tpbw4321/Slugnificant-Seven/Electrical/11.10.18 lab notes.pdf

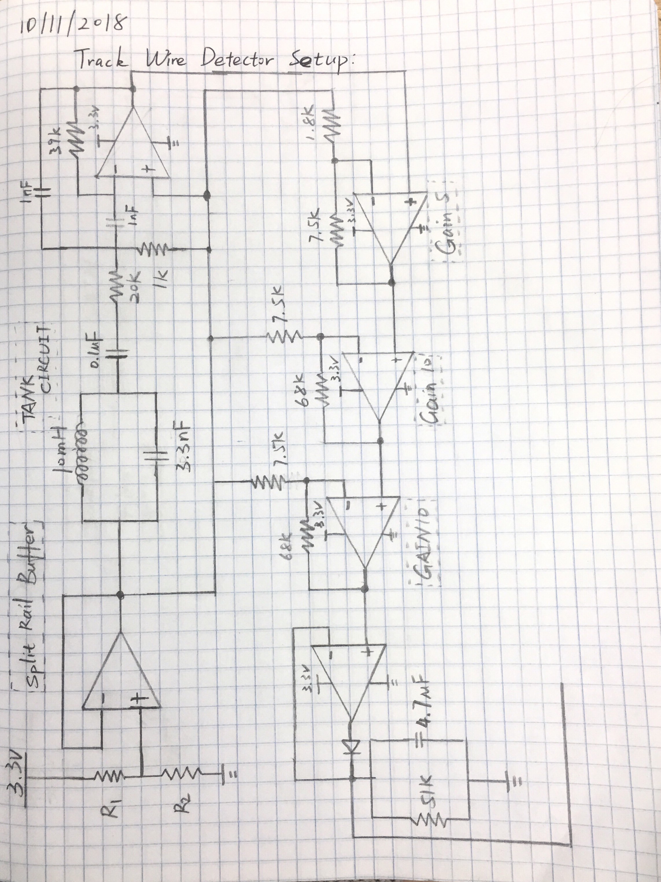
[picture p43: page 1]
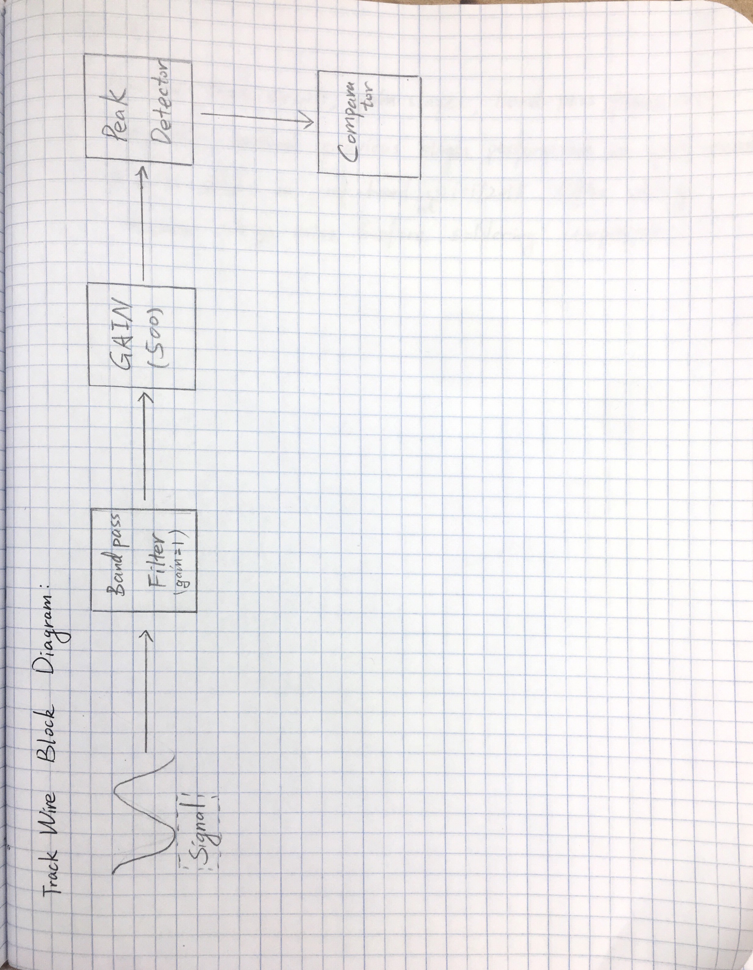
[picture p44: page 2]
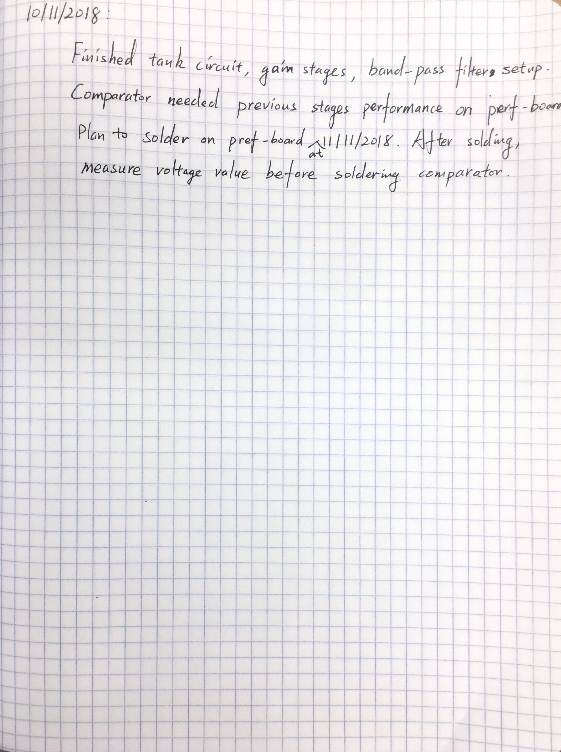
[picture p45: page 3]
