tpbw4321/Slugnificant-Seven/Mechanical/Chassis/MotorizedPlatform.PNG

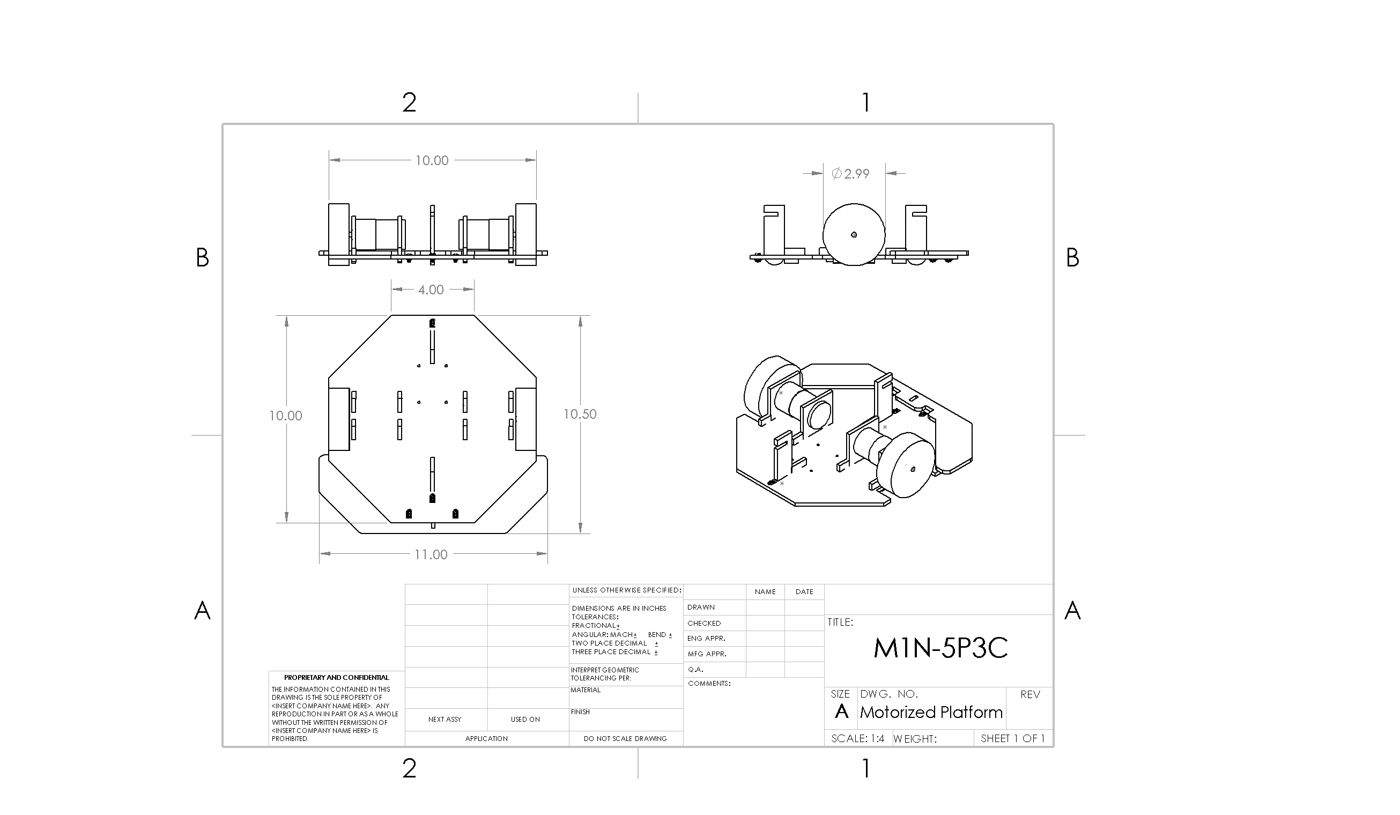
Mechanical/Chassis/MotorizedPlatform.PNG
