tpbw4321/Slugnificant-Seven/Mechanical/Mechanical Report/FiringMechanismProto.jpg

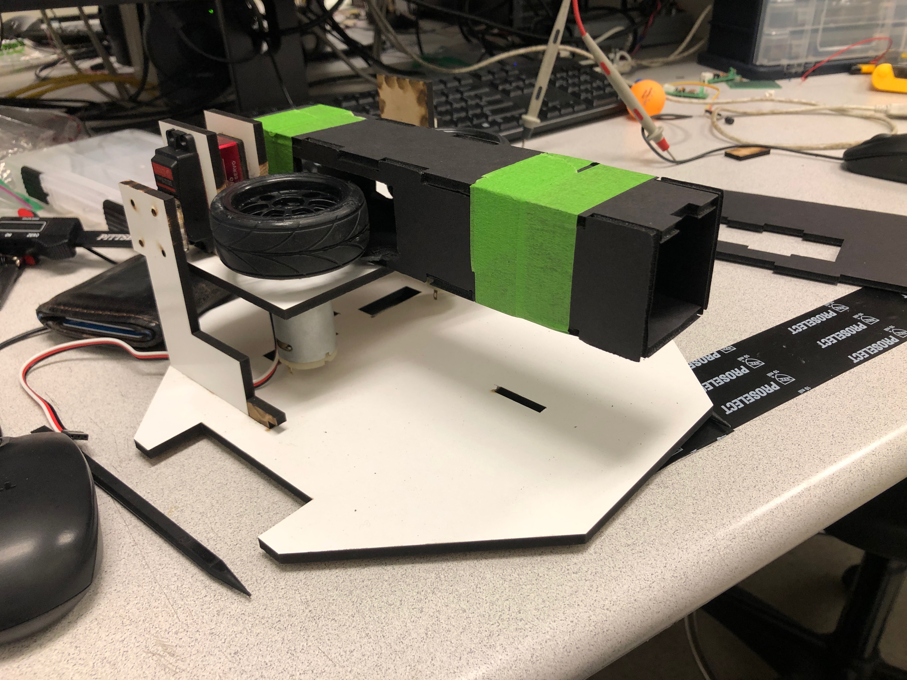
Mechanical/Mechanical Report/FiringMechanismProto.jpg
