tpbw4321/Slugnificant-Seven/Mechanical/Mechanical Report/IMG_2610.jpg

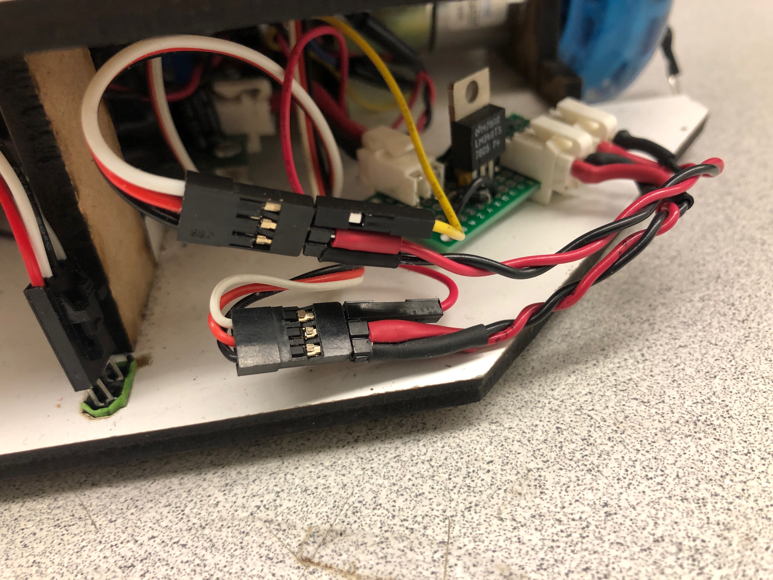
Mechanical/Mechanical Report/IMG_2610.jpg
