tpbw4321/Slugnificant-Seven/Mechanical/Motor/mobile_upload_2017-09-07_154527.jpg

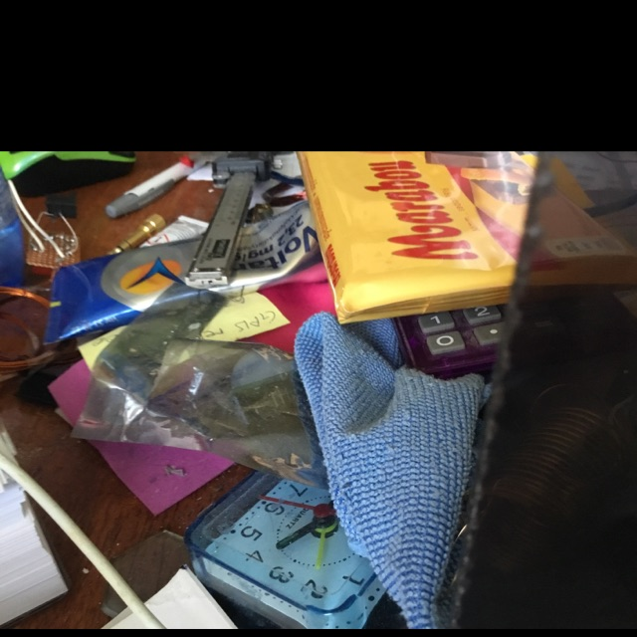
Mechanical/Motor/mobile_upload_2017-09-07_154527.jpg
