tpbw4321/Slugnificant-Seven/Mechanical/Motor/Renderings/DC 12v.296.jpg

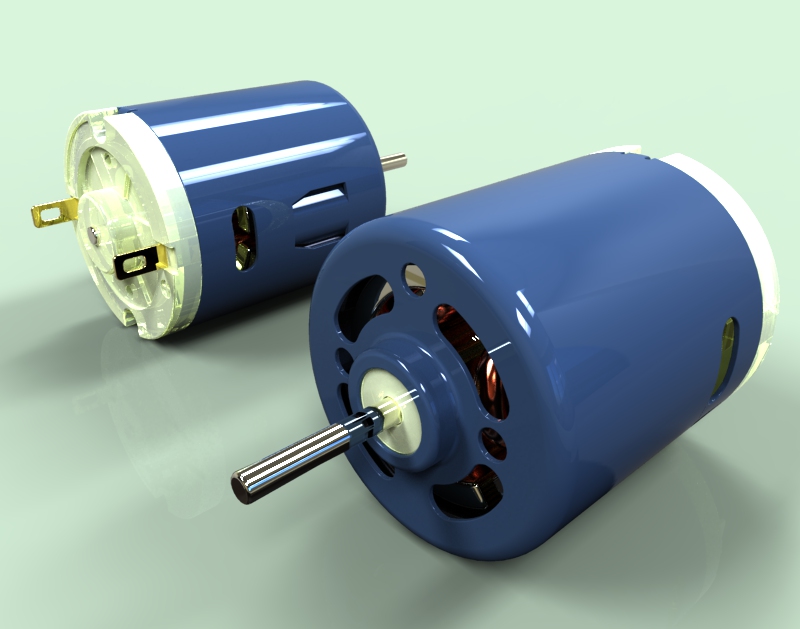
Mechanical/Motor/Renderings/DC 12v.296.jpg
