tpbw4321/Slugnificant-Seven/Mechanical/Motor/Renderings/Motor CC 12V.jpg

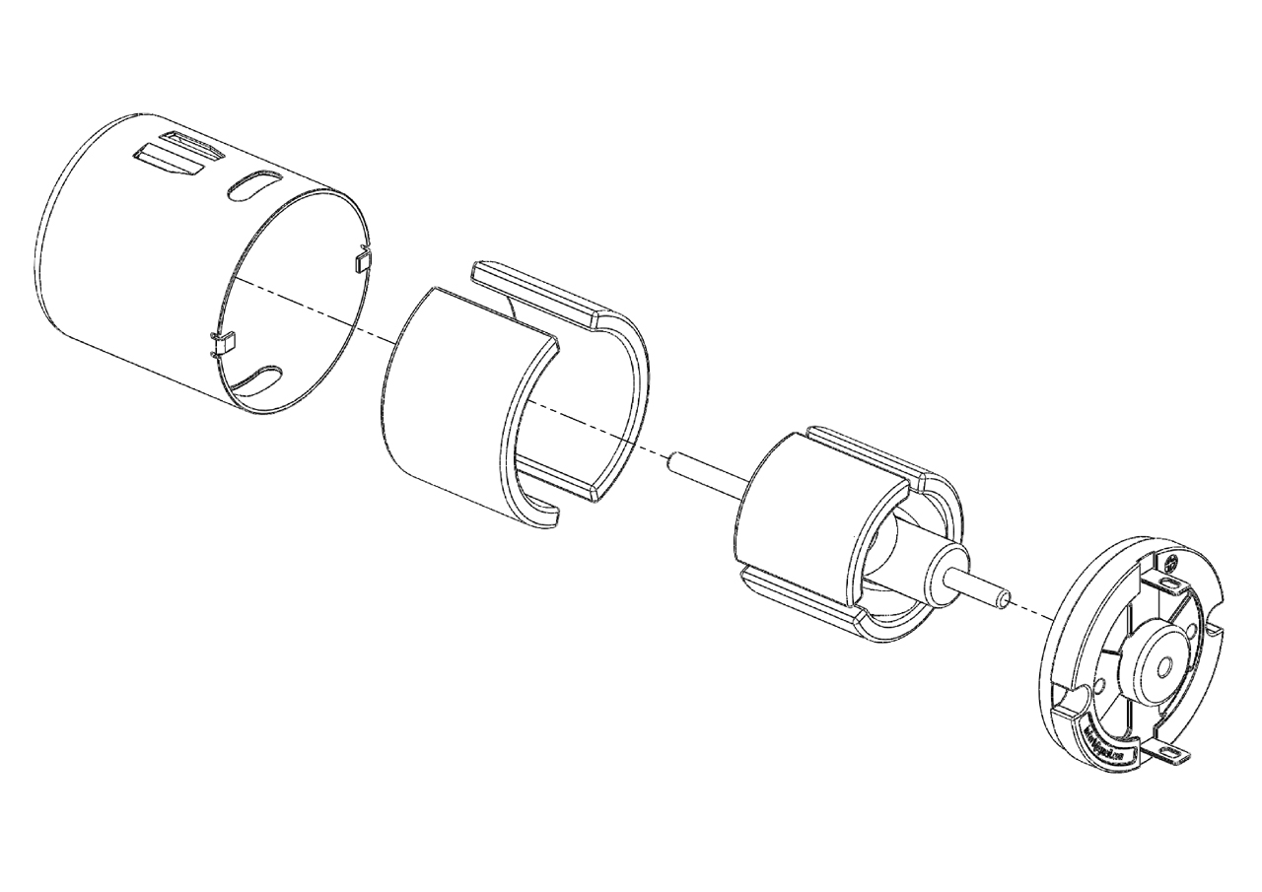
Mechanical/Motor/Renderings/Motor CC 12V.jpg
