tpbw4321/Slugnificant-Seven/Mechanical/Motor/Renderings/Render Motor CC 12V.jpg

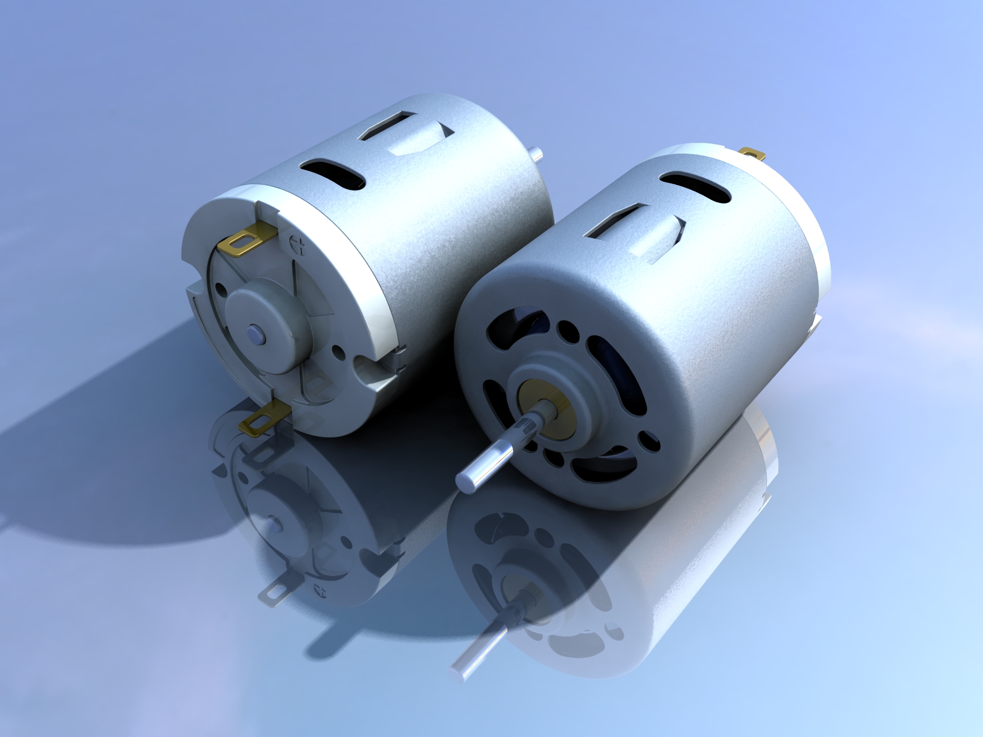
Mechanical/Motor/Renderings/Render Motor CC 12V.jpg
