tpbw4321/Slugnificant-Seven/Mechanical/Chassis/HBridge.SLDASM

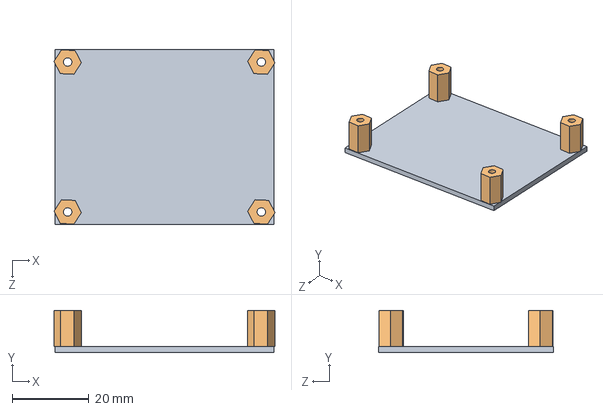
[picture p53: CAD file, 2019-06-20]
Mechanical/Chassis/HBridge.SLDASM
57.7 x 11.0 x 45.7 mm
DRV8814
HexRiser x 4
