tpbw4321/Slugnificant-Seven/Mechanical/LoadingMechanism/S90Servo/SG90 - Micro Servo 9g - Tower Pro.SLDASM

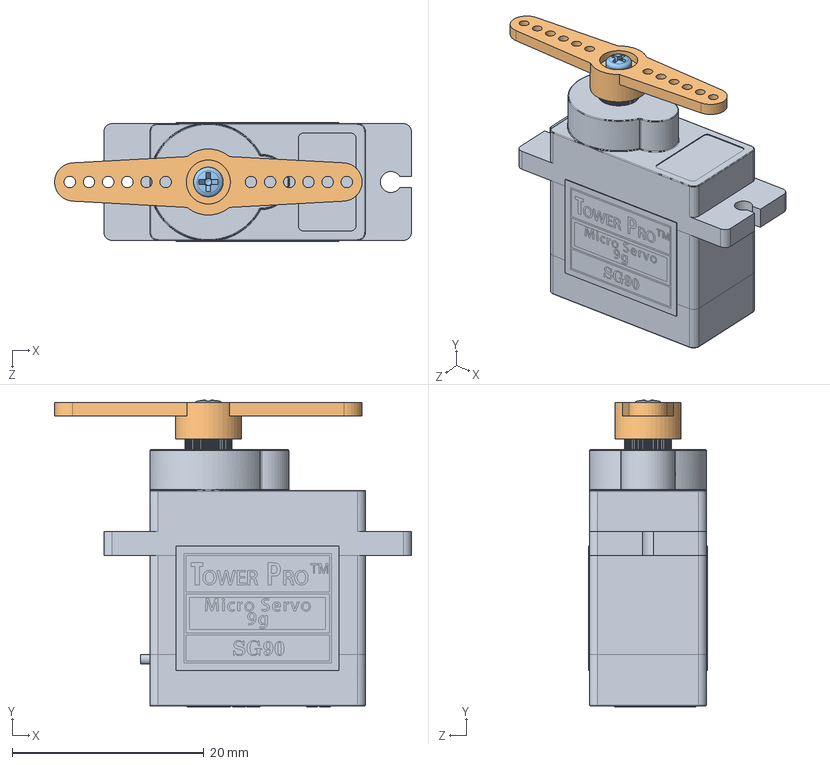
[picture p54: CAD file, 2019-06-20]
Mechanical/LoadingMechanism/S90Servo/SG90 - Micro Servo 9g - Tower Pro.SLDASM
37.2 x 32.0 x 12.4 mm
SG90 - Micro Servo 9g - Tower Pro.1
SG90 - Micro Servo 9g - Tower Pro.3
SG90 - Micro Servo 9g - Tower Pro.6
