tpbw4321/Slugnificant-Seven/Mechanical/FiringMechanism/Lewansoul_LD-27MG.SLDASM

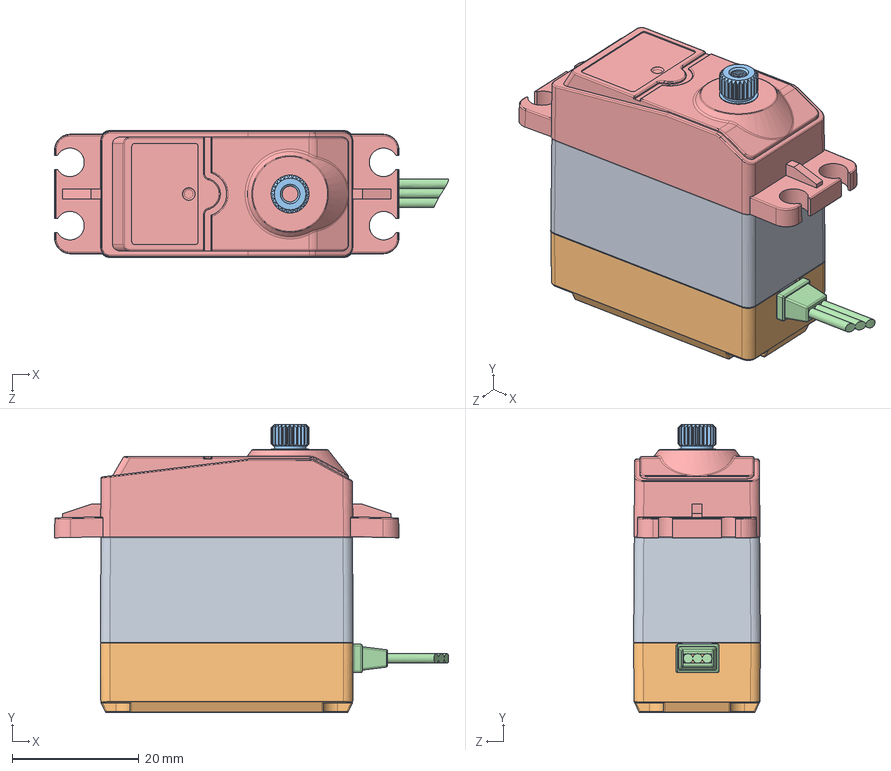
[picture p55: CAD file, 2019-06-20]
Mechanical/FiringMechanism/Lewansoul_LD-27MG.SLDASM
62.2 x 45.5 x 20.0 mm
ZK_1
DG-SZ
GE
XIANTAO
SG-JIANRONG-MG996_1
