tpbw4321/Slugnificant-Seven/Mechanical/LoadingMechanism/LoadingMechanism.SLDASM

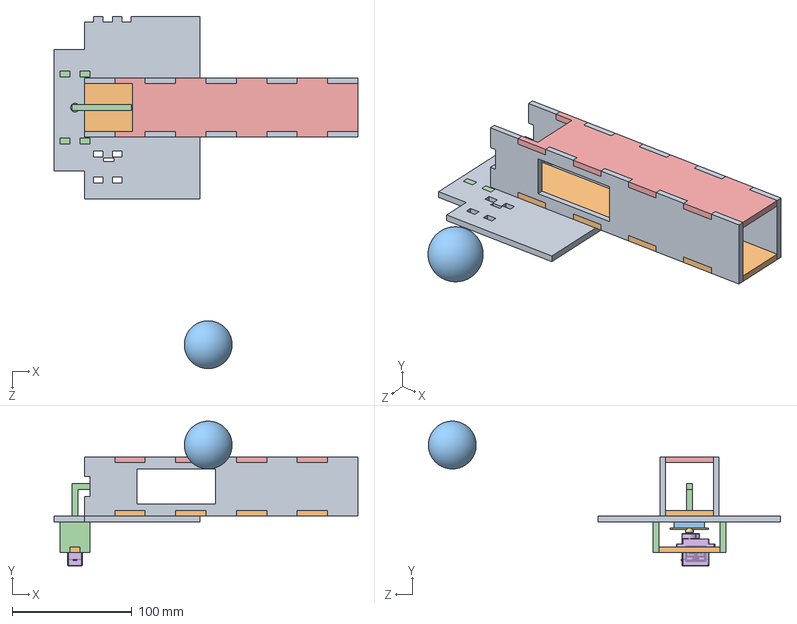
[picture p56: CAD file, 2019-06-20]
Mechanical/LoadingMechanism/LoadingMechanism.SLDASM
254.0 x 120.9 x 294.3 mm
BarrelLeftRight x 2
BarrelTopBottom
PingPongBall
BallLoadingArm
BarrelTop
SG90 - Micro Servo 9g - Tower Pro.1
SG90 - Micro Servo 9g - Tower Pro.3
SG90 - Micro Servo 9g - Tower Pro.6
FiringPlatform
LoadingServoMount
ServoAdapter
BallLoadingServoMount x 2
