tpbw4321/Slugnificant-Seven/Mechanical/Motor/DC Motor 12V - SW/DC Motor 12V.SLDASM

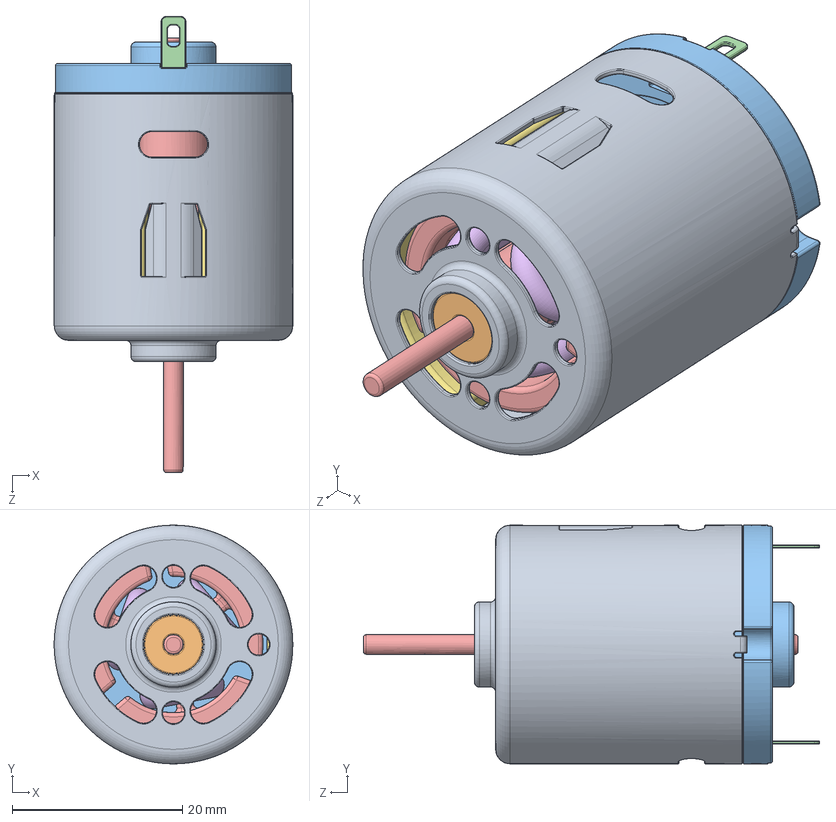
[picture p57: CAD file, 2019-06-20]
Mechanical/Motor/DC Motor 12V - SW/DC Motor 12V.SLDASM
28.0 x 28.0 x 53.5 mm
Carcaça12V
Bucha12V
Mancal12V
Terminal12V x 2
Eixo12V
Enrolamento12V x 3
Imã12V x 2
