tpbw4321/Slugnificant-Seven/Mechanical/LoadingMechanism/Hopper.SLDASM

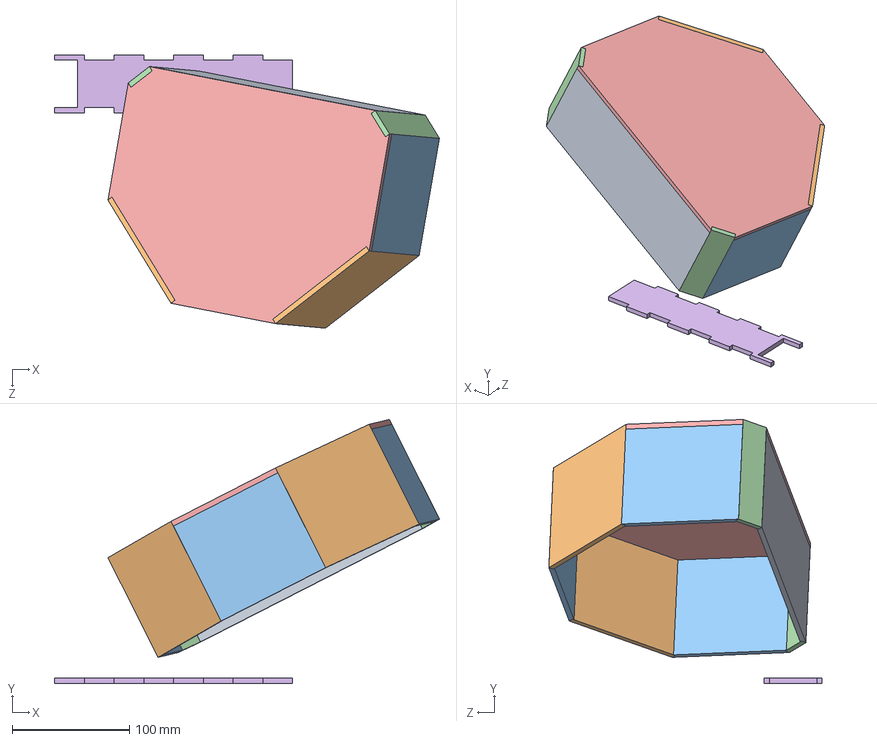
[picture p58: CAD file, 2019-06-20]
Mechanical/LoadingMechanism/Hopper.SLDASM
328.6 x 225.4 x 233.3 mm
HoppeLongWall
HopperLongCornerWall x 2
HopperNormalSide x 3
HopperShortCorner x 2
HopperTop
BarrelTop
