tpbw4321/Slugnificant-Seven/Mechanical/Chassis/CutMe.SLDASM

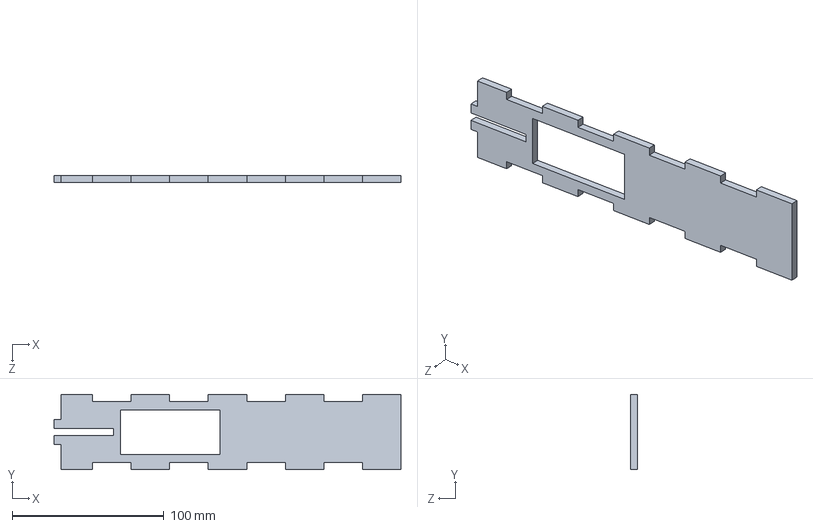
[picture p59: CAD file, 2019-06-20]
Mechanical/Chassis/CutMe.SLDASM
228.6 x 49.5 x 4.60 mm
