tpbw4321/Slugnificant-Seven/Mechanical/Chassis/M1N-5P3CAssemely.SLDASM

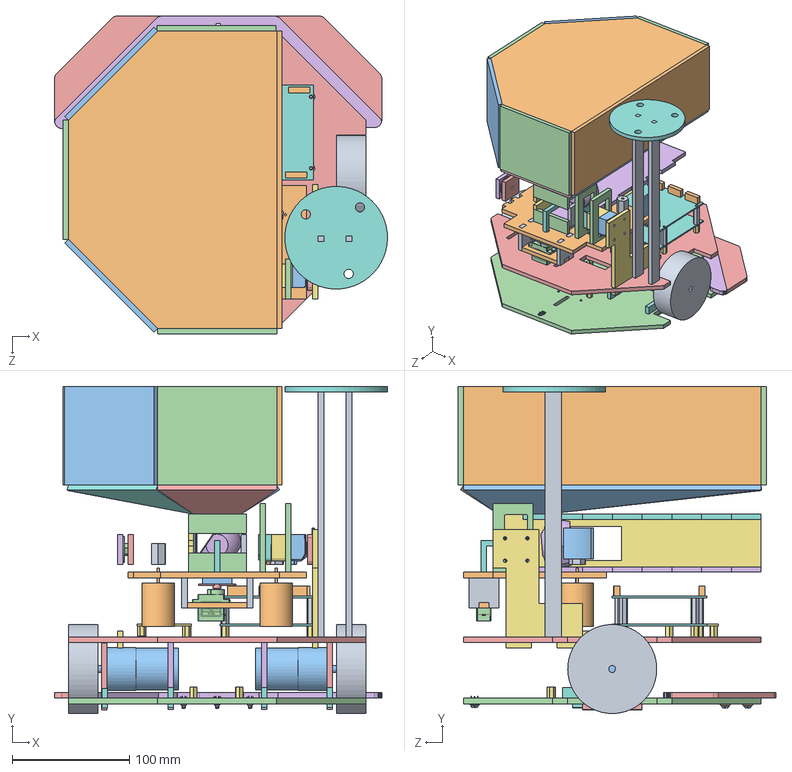
[picture p60: CAD file, 2019-06-20]
Mechanical/Chassis/M1N-5P3CAssemely.SLDASM
284.2 x 279.1 x 271.3 mm
Motor x 2
Bottom Layer
MotorMountOutter x 2
InnerMotorMount x 2
HexRiser x 12
MotorMountWedge x 4
Wheel x 2
TCRT5000 v1 x 4
LEDs x 4
Metal Contacts x 4
Top Layer
BarrelTopBottom
BarrelLeft
BarrelTop
BarrelRight
FiringPlatform
PitchingDCMotorSLDPRT x 2
PitcherWheel x 2
ServoMount x 2
FiringMechanismMount
BrassCoupling x 2
ZK_1
DG-SZ
GE
XIANTAO
SG-JIANRONG-MG996_1
BallBearing
ServoGearAdapter
PlatformBearingMount
PlatformServoMount
BallLoadingArm
BallLoadingServoMount x 2
LoadingServoMount
ServoAdapter
SG90 - Micro Servo 9g - Tower Pro.1
SG90 - Micro Servo 9g - Tower Pro.3
SG90 - Micro Servo 9g - Tower Pro.6
PlatformMountWedge x 2
BeaconPlatform
BeaconStand x 2
HopperTop
HopperLongCornerWall x 2
HopperNormalSide x 3
HopperBottomBack
HopperBottomFront
HopperBottomLeft
HopperBottomBackLeft
HopperBottomFrontRight
HopperRightWall
HopperBottomRight
BarrelEndCap x 2
BumperV2
DS3658 PCB
UnoStackPCB x 2
TallHexRiser x 4
UnoStackConnector x 5
