tpbw4321/Slugnificant-Seven/Mechanical/FiringMechanism/BallLoadDemo.SLDASM

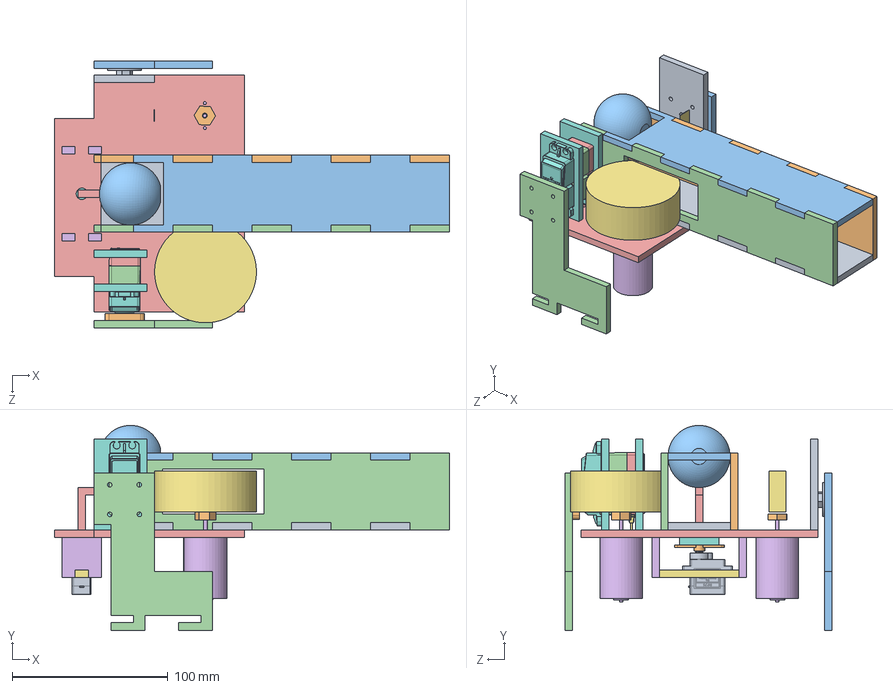
[picture p61: CAD file, 2019-06-20]
Mechanical/FiringMechanism/BallLoadDemo.SLDASM
254.0 x 131.9 x 171.4 mm
BarrelTopBottom
BarrelTop
BarrelRight
FiringPlatform
PitchingDCMotorSLDPRT x 2
PitcherWheel
ServoMount x 2
BrassCoupling x 2
PingPongBall
ZK_1
DG-SZ
GE
XIANTAO
SG-JIANRONG-MG996_1
BallLoadingArm
BallLoadingServoMount x 2
LoadingServoMount
ServoAdapter
SG90 - Micro Servo 9g - Tower Pro.1
SG90 - Micro Servo 9g - Tower Pro.3
SG90 - Micro Servo 9g - Tower Pro.6
