tpbw4321/Slugnificant-Seven/Mechanical/Chassis/WedgesCut.SLDASM

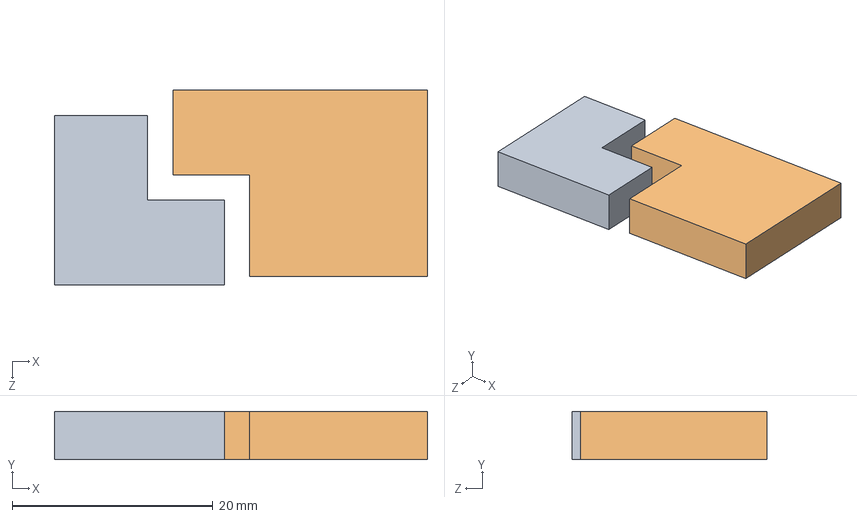
[picture p62: CAD file, 2019-06-20]
Mechanical/Chassis/WedgesCut.SLDASM
37.2 x 4.80 x 19.5 mm
MotorMountWedge
SkidWedge
