tpbw4321/Slugnificant-Seven/Mechanical/Chassis/DS3658.SLDASM

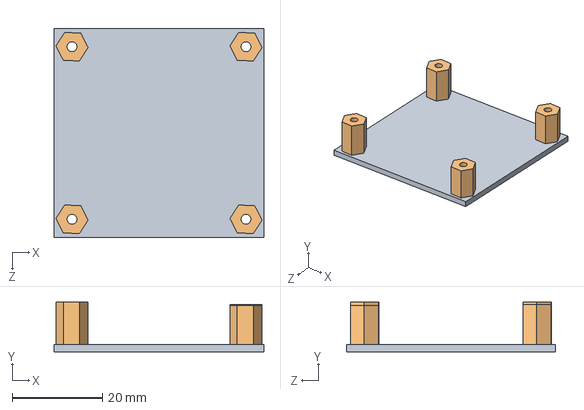
[picture p63: CAD file, 2019-06-20]
Mechanical/Chassis/DS3658.SLDASM
46.6 x 11.0 x 46.3 mm
DS3658 PCB
HexRiser x 4
