tpbw4321/Slugnificant-Seven/Mechanical/Chassis/Wheel.SLDASM

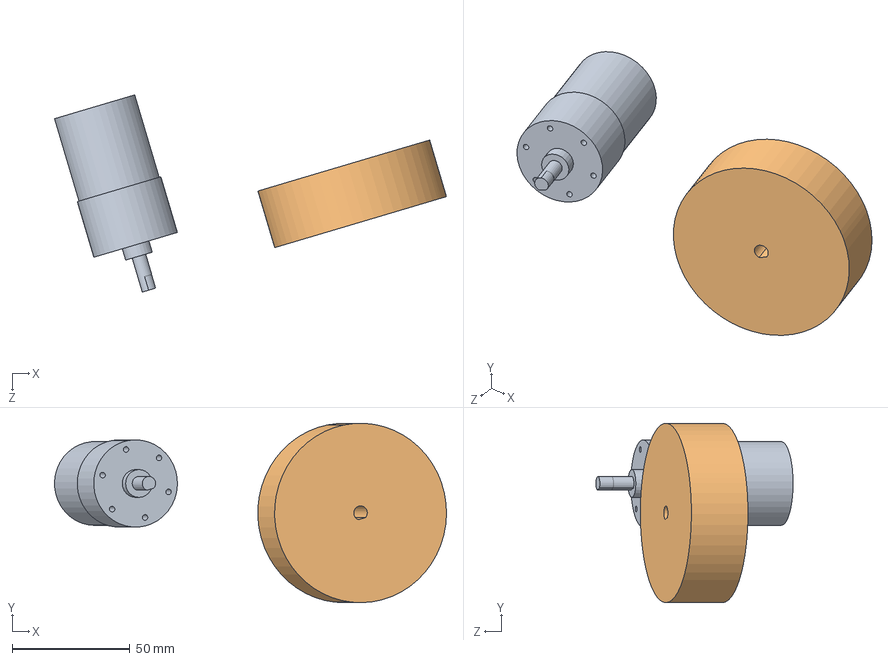
[picture p64: CAD file, 2019-06-20]
Mechanical/Chassis/Wheel.SLDASM
166.1 x 76.0 x 83.6 mm
Motor
Wheel
