tpbw4321/Slugnificant-Seven/Mechanical/Chassis/HopperCut.SLDASM

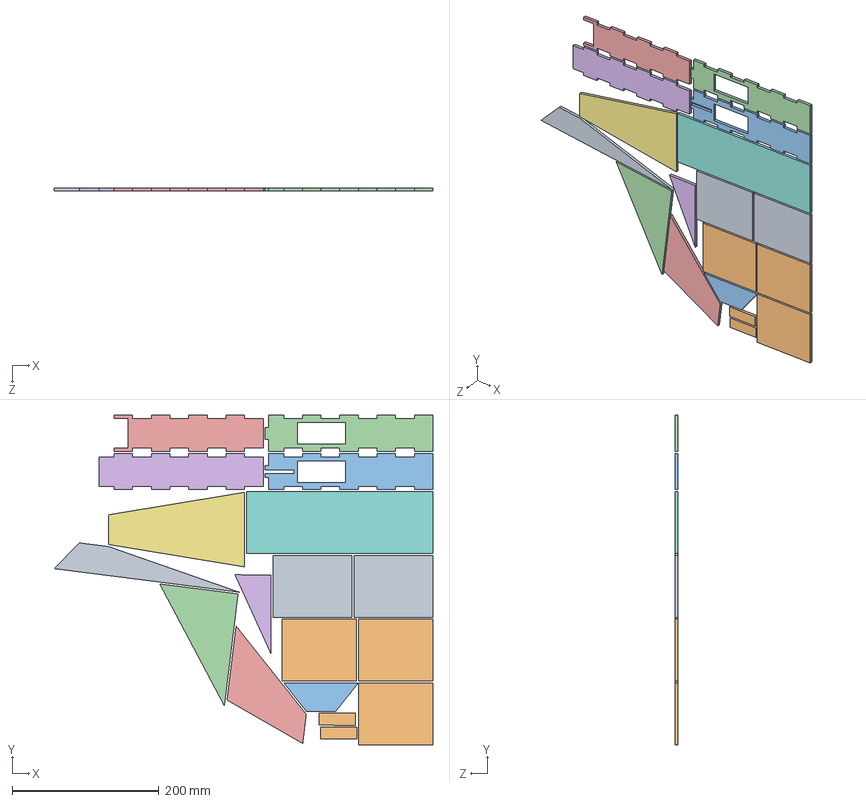
[picture p66: CAD file, 2019-06-20]
Mechanical/Chassis/HopperCut.SLDASM
516.1 x 448.9 x 4.60 mm
HopperLongCornerWall x 2
HopperNormalSide x 3
HopperBottomBack
HopperBottomFront
HopperBottomLeft
HopperBottomBackLeft
HopperBottomFrontRight
HopperRightWall
HopperBottomRight
BarrelEndCap x 2
BarrelLeft
BarrelRight
BarrelTop
BarrelTopBottom
