tpbw4321/Slugnificant-Seven/Mechanical/Chassis/TCRT5000.SLDASM

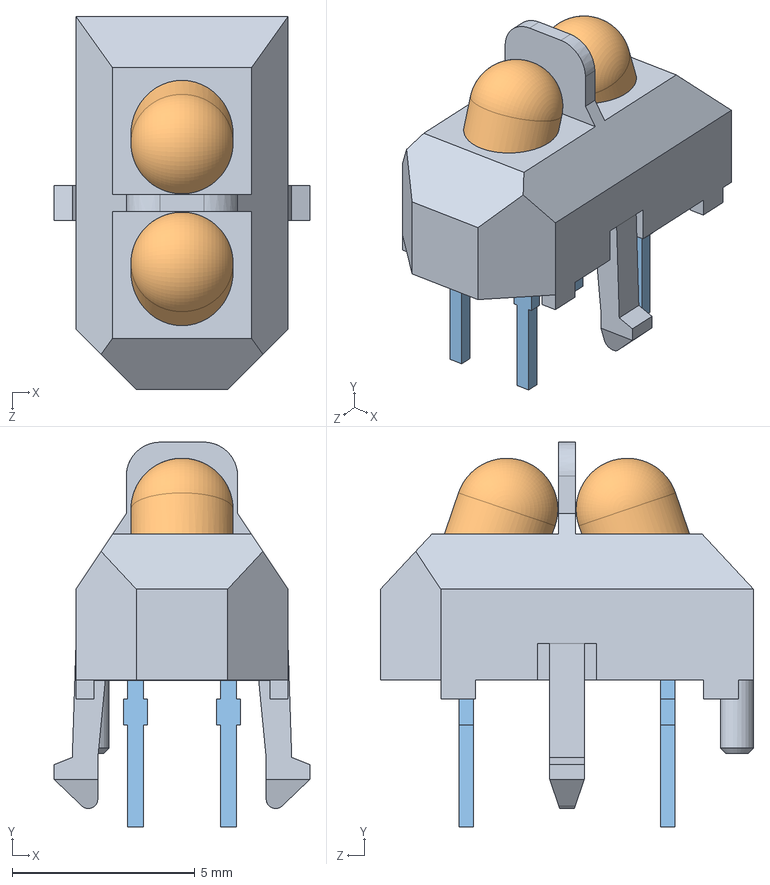
[picture p67: CAD file, 2019-06-20]
Mechanical/Chassis/TCRT5000.SLDASM
7.00 x 10.5 x 10.2 mm
TCRT5000 v1
LEDs
Metal Contacts
