tpbw4321/Slugnificant-Seven/Mechanical/Chassis/MotorMount.SLDASM

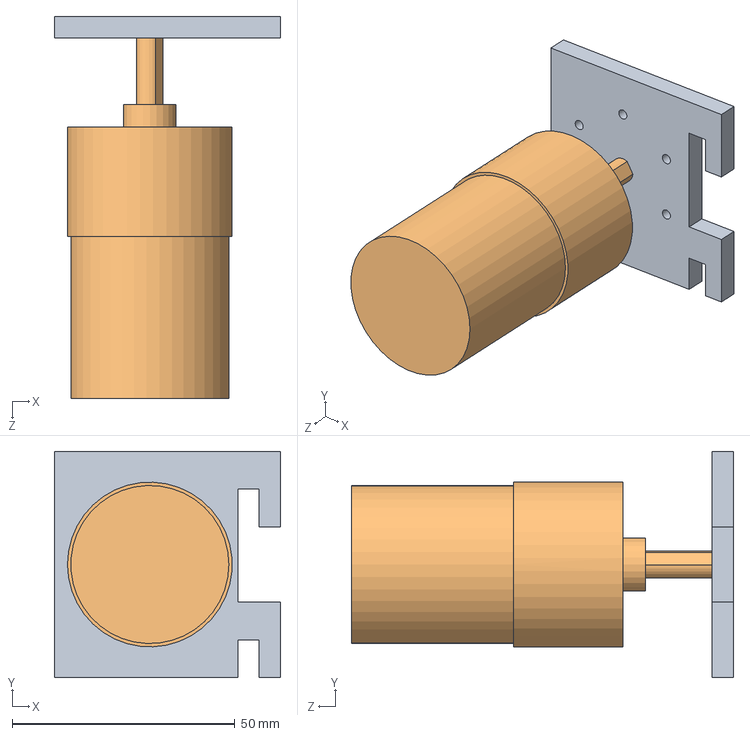
[picture p68: CAD file, 2019-06-20]
Mechanical/Chassis/MotorMount.SLDASM
50.8 x 50.8 x 85.8 mm
MotorMountOutter
Motor
