tpbw4321/Slugnificant-Seven/Mechanical/Chassis/UnoStack.SLDASM

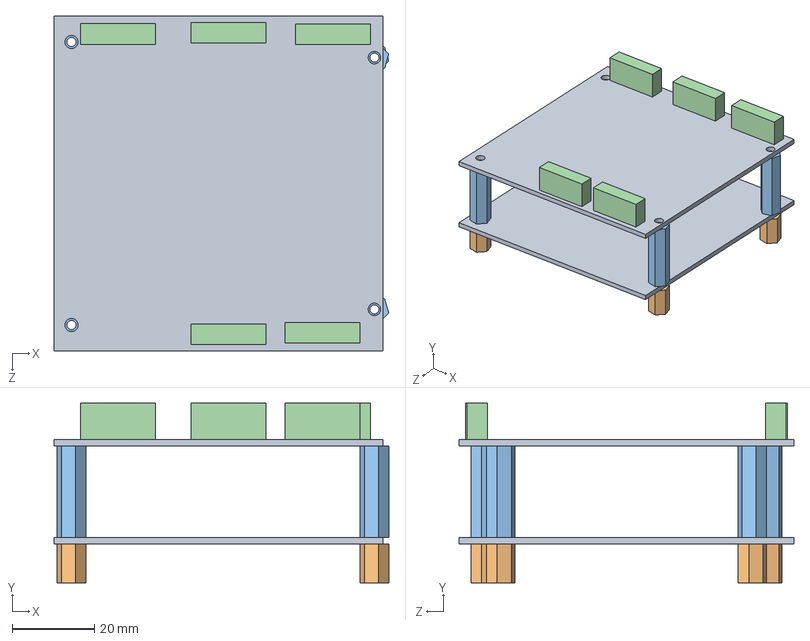
[picture p69: CAD file, 2019-06-20]
Mechanical/Chassis/UnoStack.SLDASM
81.2 x 43.6 x 81.3 mm
UnoStackPCB x 2
HexRiser x 4
TallHexRiser x 4
UnoStackConnector x 5
