tpbw4321/Slugnificant-Seven/Mechanical/Chassis/Bottom.SLDASM

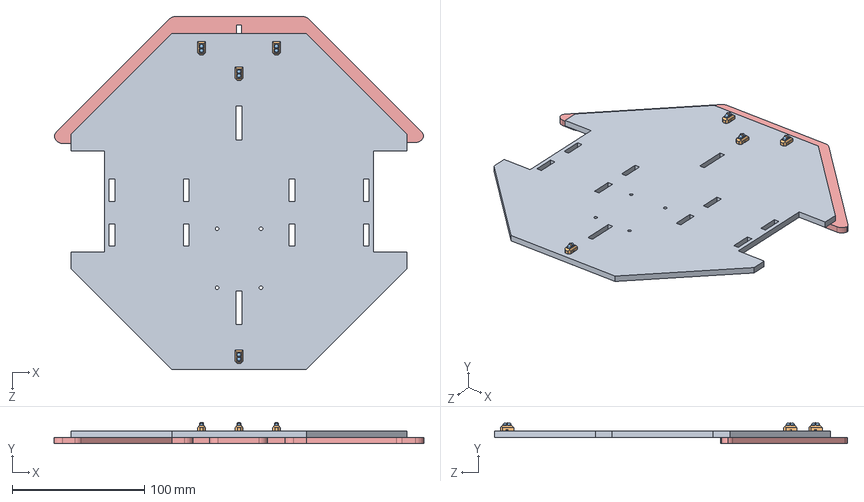
[picture p70: CAD file, 2019-06-20]
Mechanical/Chassis/Bottom.SLDASM
279.2 x 16.1 x 266.7 mm
Bottom Layer
TCRT5000 v1 x 4
LEDs x 4
Metal Contacts x 4
Bumper
