tpbw4321/Slugnificant-Seven/Mechanical/FiringMechanism/PitchingDCMotorSLDPRT.SLDPRT

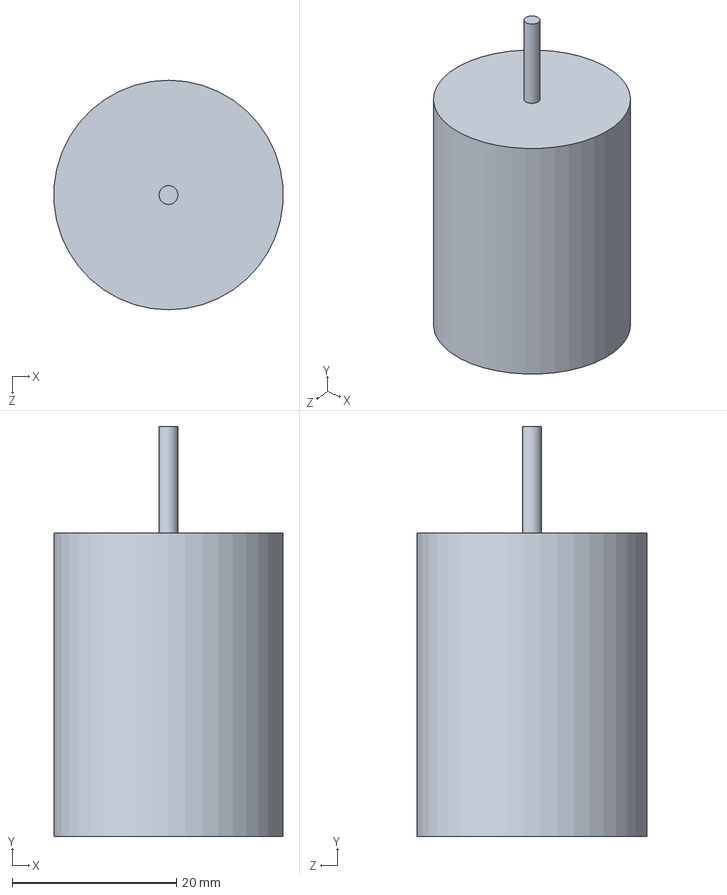
[picture p71: CAD file, 2019-06-20]
Mechanical/FiringMechanism/PitchingDCMotorSLDPRT.SLDPRT
27.9 x 50.0 x 28.0 mm
