tpbw4321/Slugnificant-Seven/Mechanical/LoadingMechanism/BallLoadingServoMount.SLDPRT

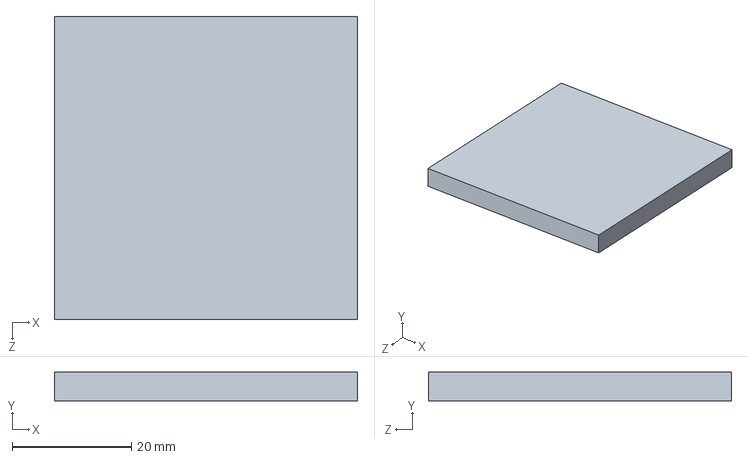
[picture p72: CAD file, 2019-06-20]
Mechanical/LoadingMechanism/BallLoadingServoMount.SLDPRT
50.8 x 4.83 x 50.8 mm
