tpbw4321/Slugnificant-Seven/Mechanical/Motor/DC Motor 12V - SW/Terminal12V.SLDPRT

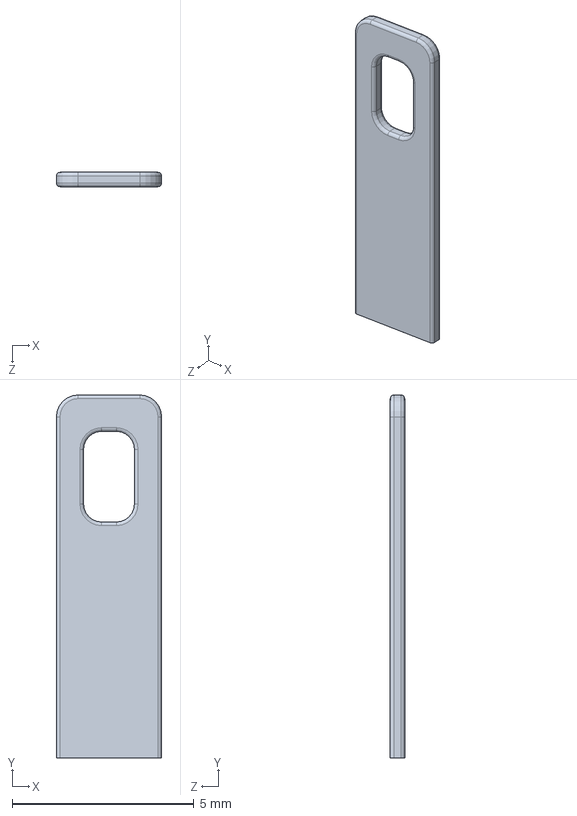
[picture p73: CAD file, 2019-06-20]
Mechanical/Motor/DC Motor 12V - SW/Terminal12V.SLDPRT
2.90 x 10.0 x 0.4 mm
