tpbw4321/Slugnificant-Seven/Mechanical/FiringMechanism/BarrelTopBottom.SLDPRT

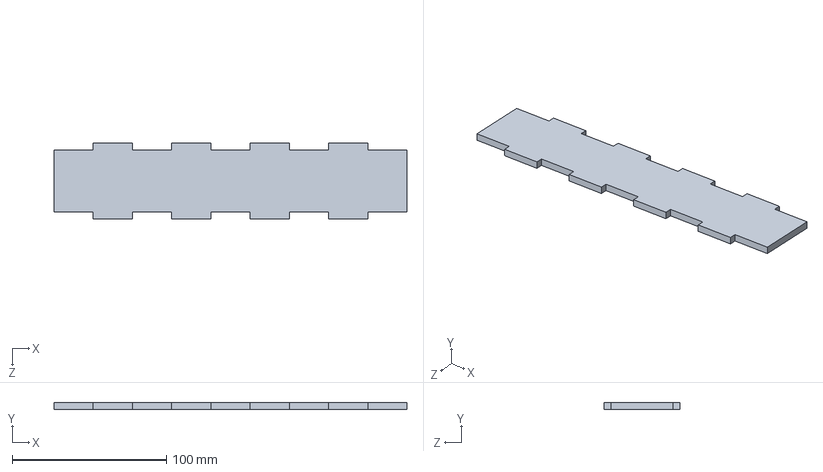
[picture p74: CAD file, 2019-06-20]
Mechanical/FiringMechanism/BarrelTopBottom.SLDPRT
228.6 x 4.60 x 49.2 mm
