tpbw4321/Slugnificant-Seven/Mechanical/LoadingMechanism/S90Servo/SG90 - Micro Servo 9g - Tower Pro.6.SLDPRT

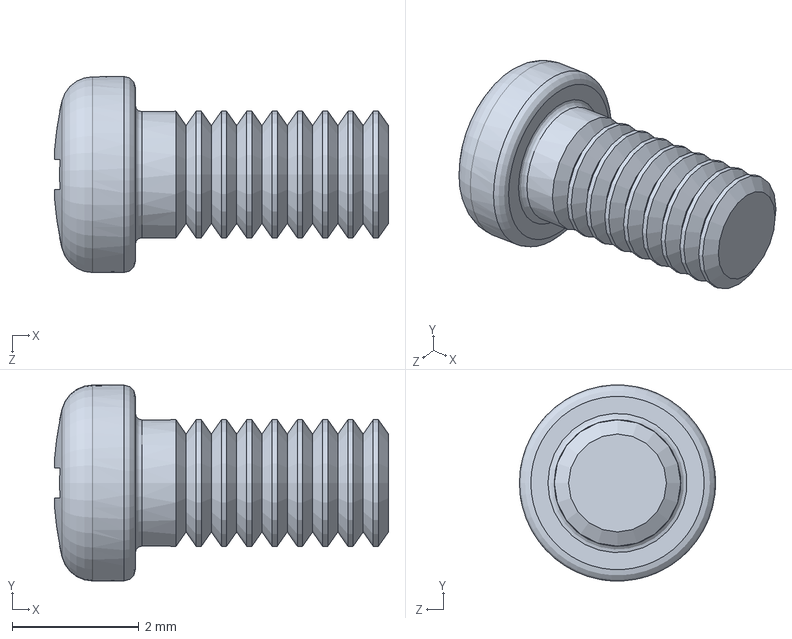
[picture p75: CAD file, 2019-06-20]
Mechanical/LoadingMechanism/S90Servo/SG90 - Micro Servo 9g - Tower Pro.6.SLDPRT
5.28 x 3.10 x 3.10 mm
