tpbw4321/Slugnificant-Seven/Mechanical/LoadingMechanism/ServoAdapter.SLDPRT

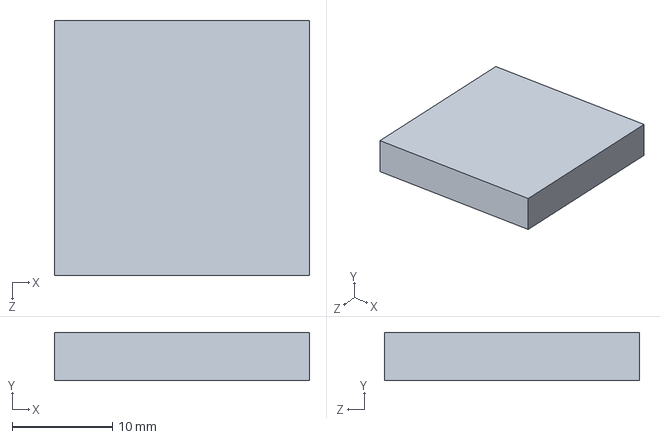
[picture p76: CAD file, 2019-06-20]
Mechanical/LoadingMechanism/ServoAdapter.SLDPRT
25.4 x 4.83 x 25.4 mm
