tpbw4321/Slugnificant-Seven/Mechanical/Motor/DC Motor 12V - SW/Im¦12V.SLDPRT

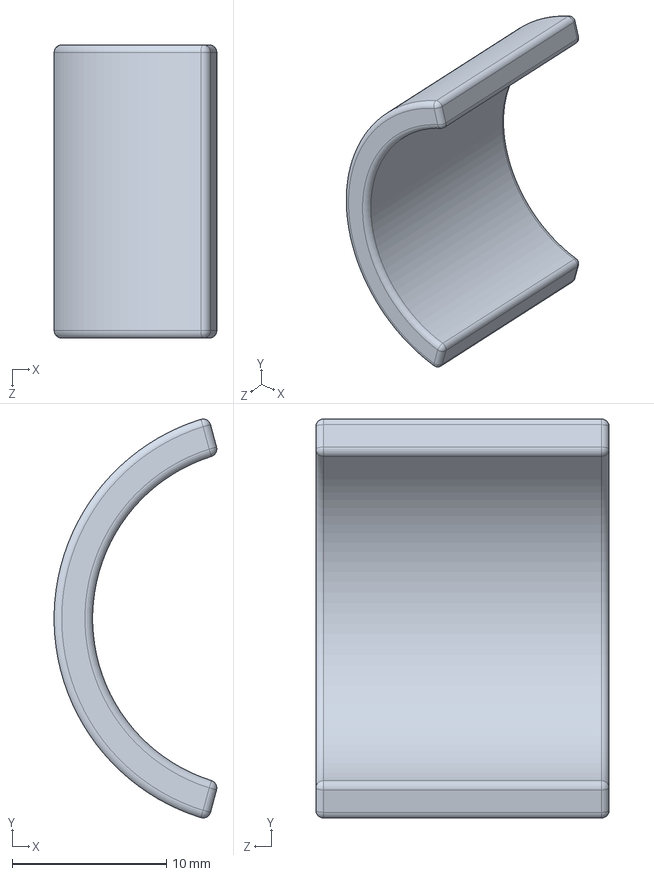
[picture p77: CAD file, 2019-06-20]
Mechanical/Motor/DC Motor 12V - SW/Im¦12V.SLDPRT
10.5 x 25.8 x 19.0 mm
