tpbw4321/Slugnificant-Seven/Mechanical/Chassis/BeaconStand.SLDPRT

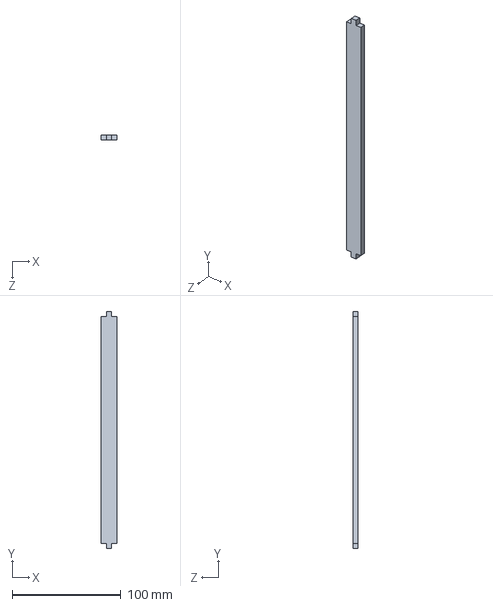
[picture p78: CAD file, 2019-06-20]
Mechanical/Chassis/BeaconStand.SLDPRT
14.4 x 218.4 x 4.83 mm
