tpbw4321/Slugnificant-Seven/Mechanical/FiringMechanism/BallBearing.SLDPRT

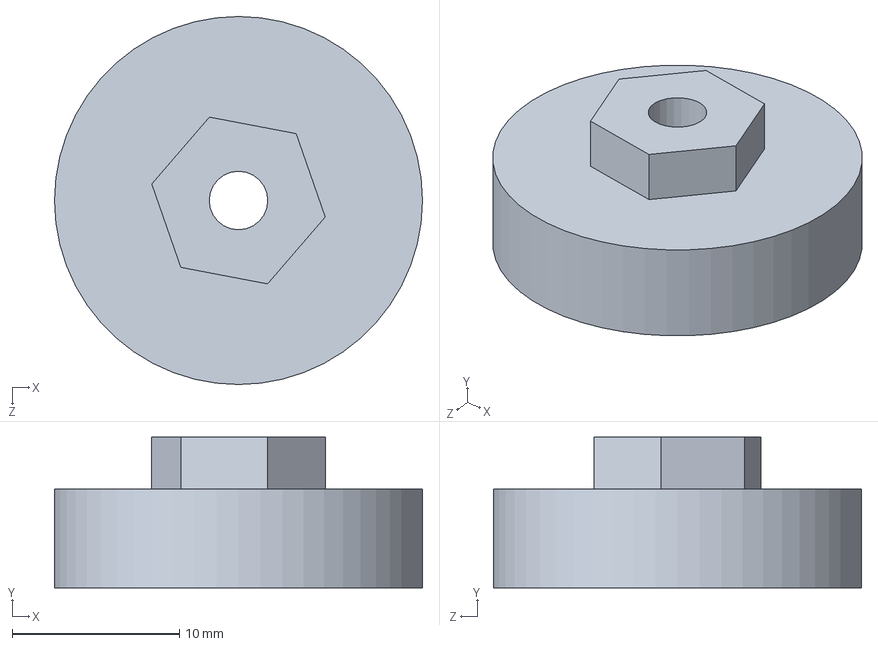
[picture p79: CAD file, 2019-06-20]
Mechanical/FiringMechanism/BallBearing.SLDPRT
22.0 x 9.00 x 22.0 mm
