tpbw4321/Slugnificant-Seven/Mechanical/LoadingMechanism/LoadingServoMount.SLDPRT

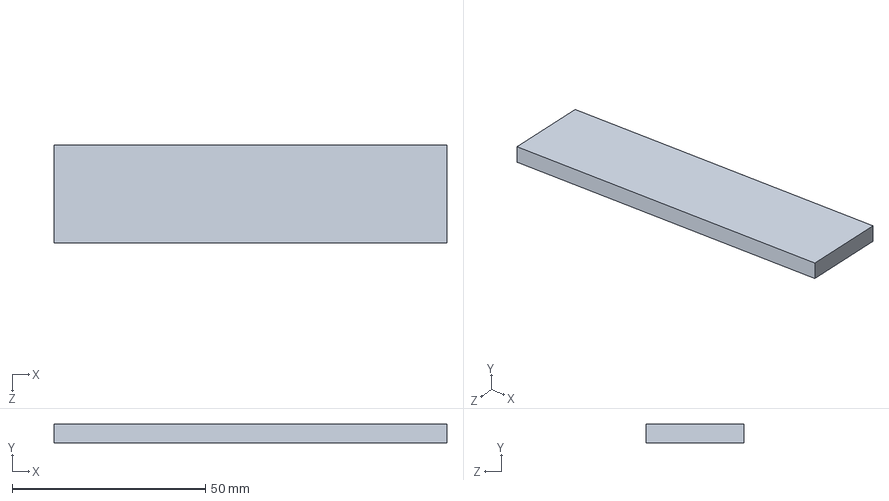
[picture p80: CAD file, 2019-06-20]
Mechanical/LoadingMechanism/LoadingServoMount.SLDPRT
101.6 x 4.80 x 25.4 mm
