tpbw4321/Slugnificant-Seven/Mechanical/Motor/DC Motor 12V - SW/Carcaça12V.SLDPRT

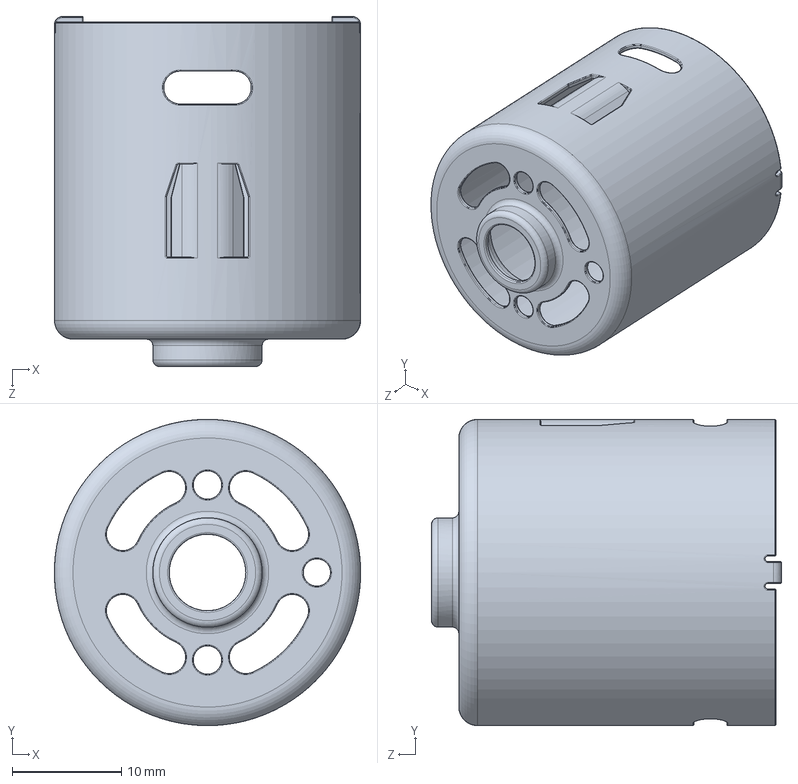
[picture p82: CAD file, 2019-06-20]
Mechanical/Motor/DC Motor 12V - SW/Carcaça12V.SLDPRT
28.0 x 28.0 x 32.0 mm
