tpbw4321/Slugnificant-Seven/Mechanical/Chassis/HopperBottomLeft.SLDPRT

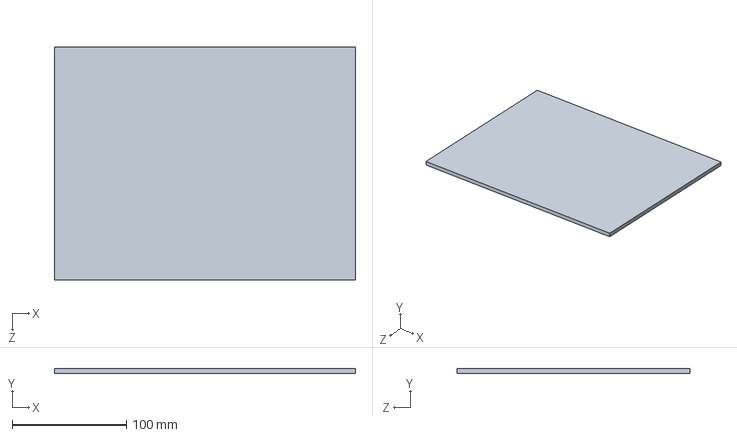
[picture p83: CAD file, 2019-06-20]
Mechanical/Chassis/HopperBottomLeft.SLDPRT
263.3 x 4.60 x 204.2 mm
