tpbw4321/Slugnificant-Seven/Mechanical/LoadingMechanism/S90Servo/SG90 - Micro Servo 9g - Tower Pro.3.SLDPRT

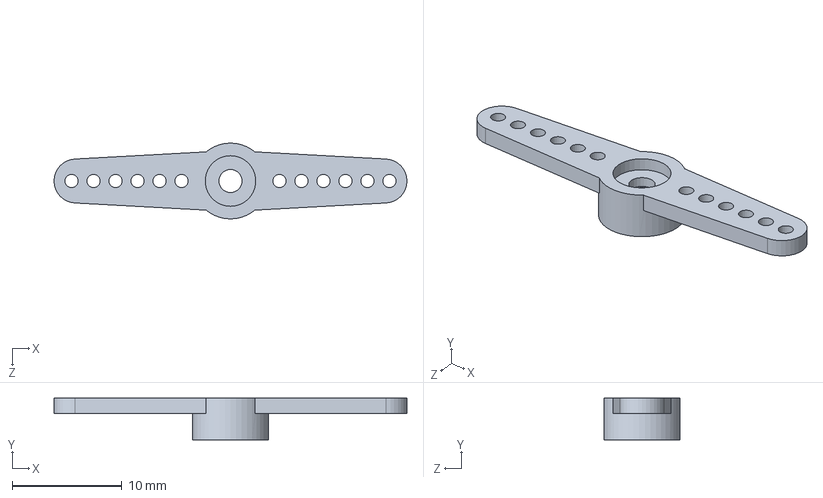
[picture p84: CAD file, 2019-06-20]
Mechanical/LoadingMechanism/S90Servo/SG90 - Micro Servo 9g - Tower Pro.3.SLDPRT
32.1 x 3.80 x 6.90 mm
