tpbw4321/Slugnificant-Seven/Mechanical/FiringMechanism/ServoGearAdapter.SLDPRT

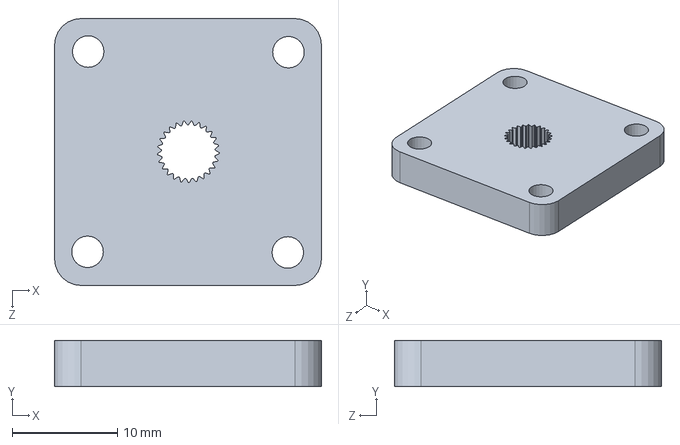
[picture p85: CAD file, 2019-06-20]
Mechanical/FiringMechanism/ServoGearAdapter.SLDPRT
25.4 x 4.40 x 25.4 mm
