tpbw4321/Slugnificant-Seven/Mechanical/LoadingMechanism/BallLoadingArm.SLDPRT

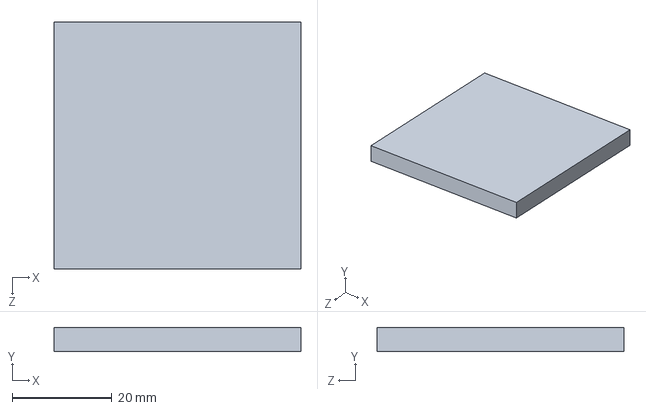
[picture p86: CAD file, 2019-06-20]
Mechanical/LoadingMechanism/BallLoadingArm.SLDPRT
49.6 x 4.83 x 49.6 mm
