tpbw4321/Slugnificant-Seven/Mechanical/LoadingMechanism/S90Servo/SG90 - Micro Servo 9g - Tower Pro.1.SLDPRT

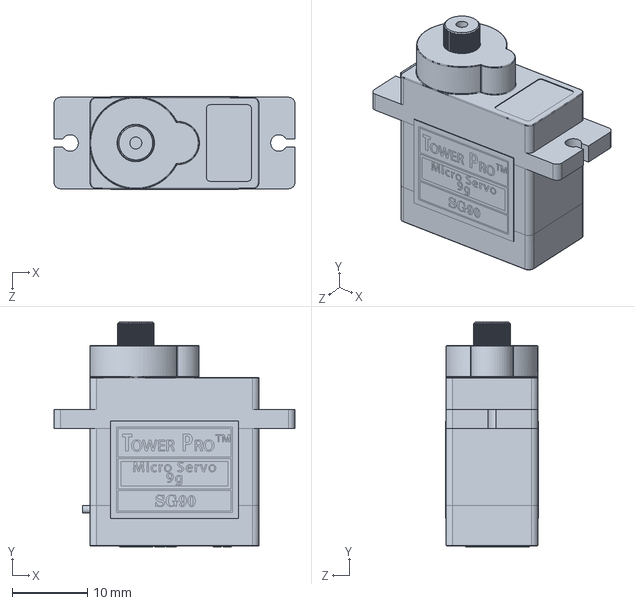
[picture p87: CAD file, 2019-06-20]
Mechanical/LoadingMechanism/S90Servo/SG90 - Micro Servo 9g - Tower Pro.1.SLDPRT
32.1 x 30.0 x 12.4 mm
