tpbw4321/Slugnificant-Seven/Mechanical/Motor/DC Motor 12V - SW/Enrolamento12V.SLDPRT

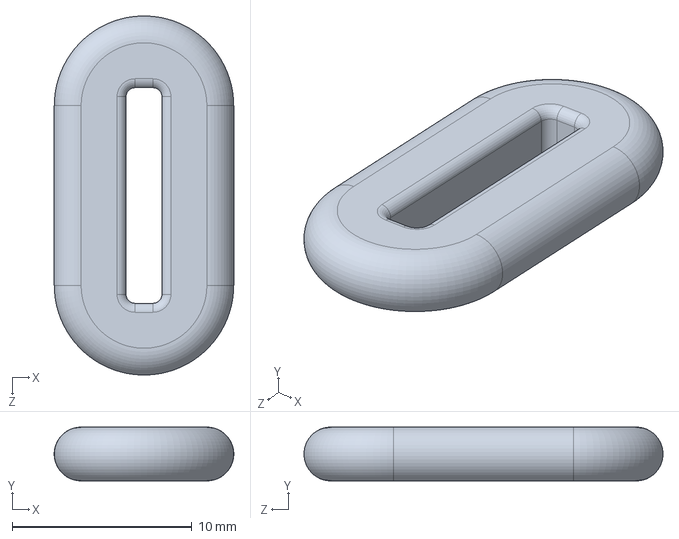
[picture p88: CAD file, 2019-06-20]
Mechanical/Motor/DC Motor 12V - SW/Enrolamento12V.SLDPRT
9.99 x 3.00 x 20.0 mm
