tpbw4321/Slugnificant-Seven/Mechanical/FiringMechanism/BarrelLeft.SLDPRT

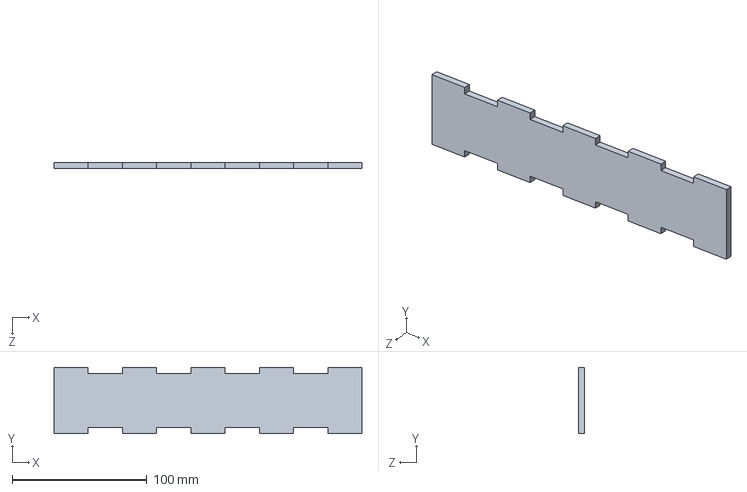
[picture p89: CAD file, 2019-06-20]
Mechanical/FiringMechanism/BarrelLeft.SLDPRT
228.6 x 49.2 x 4.60 mm
