tpbw4321/Slugnificant-Seven/Mechanical/Motor/DC Motor 12V - SW/Mancal12V.SLDPRT

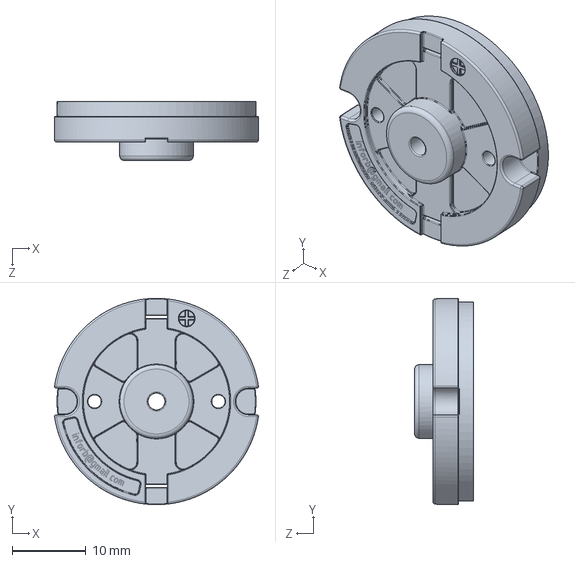
[picture p91: CAD file, 2019-06-20]
Mechanical/Motor/DC Motor 12V - SW/Mancal12V.SLDPRT
27.7 x 28.0 x 8.00 mm
