tpbw4321/Slugnificant-Seven/Mechanical/Motor/DC Motor 12V - SW/Bucha12V.SLDPRT

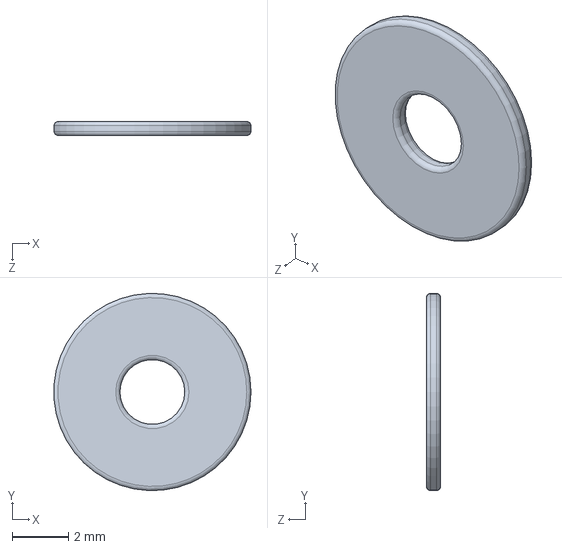
[picture p93: CAD file, 2019-06-20]
Mechanical/Motor/DC Motor 12V - SW/Bucha12V.SLDPRT
6.99 x 7.00 x 0.5 mm
