tpbw4321/Slugnificant-Seven/Mechanical/FiringMechanism/FiringMechanismMount.SLDPRT

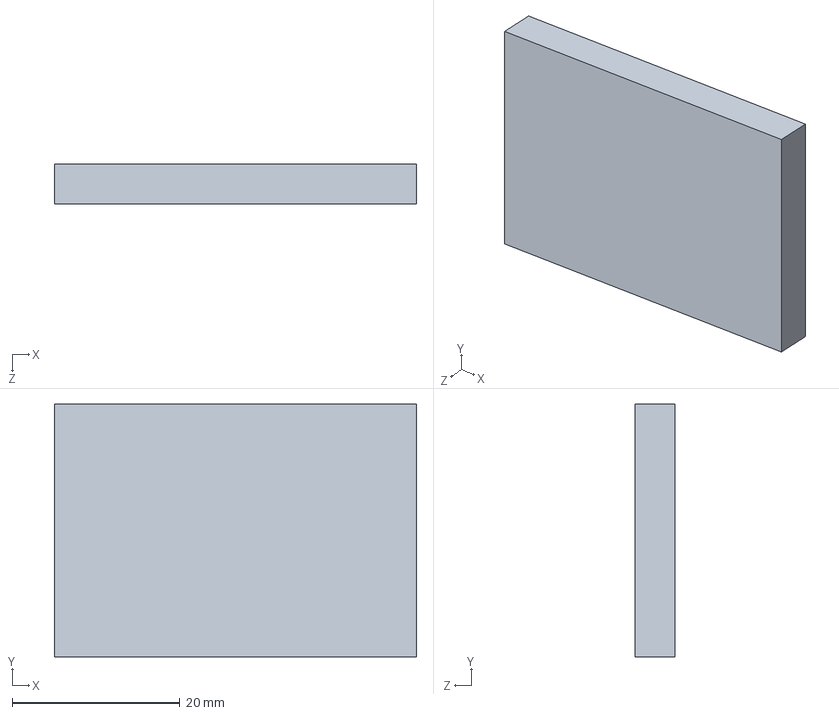
[picture p94: CAD file, 2019-06-20]
Mechanical/FiringMechanism/FiringMechanismMount.SLDPRT
43.2 x 30.1 x 4.80 mm
