tpbw4321/Slugnificant-Seven/Mechanical/Motor/DC Motor 12V - SW/Eixo12V.SLDPRT

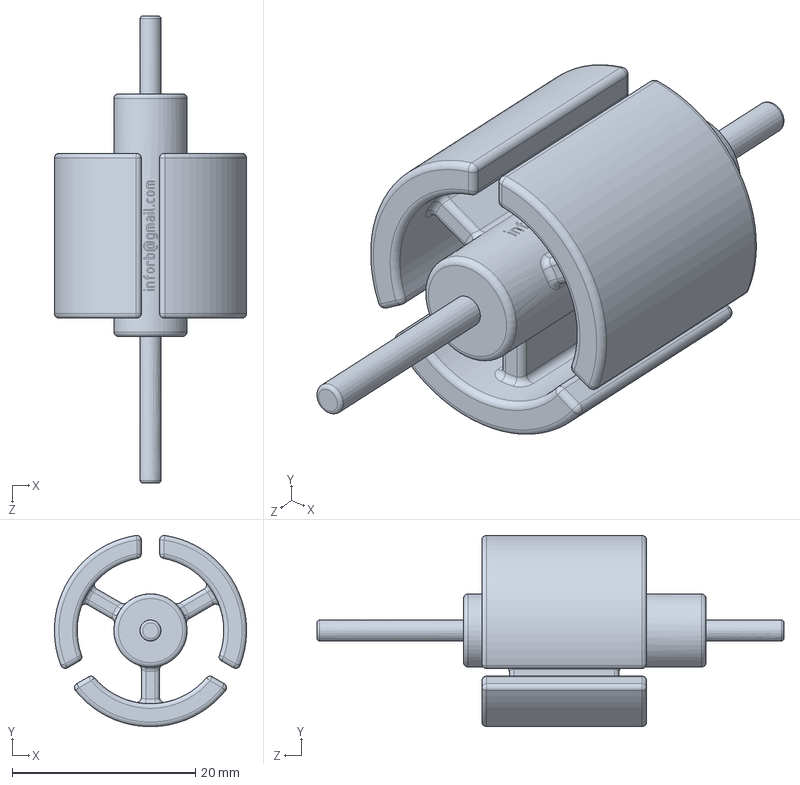
[picture p95: CAD file, 2019-06-20]
Mechanical/Motor/DC Motor 12V - SW/Eixo12V.SLDPRT
21.0 x 20.9 x 51.0 mm
