tpbw4321/Slugnificant-Seven/Mechanical/Chassis/UnoStackPCB.SLDPRT

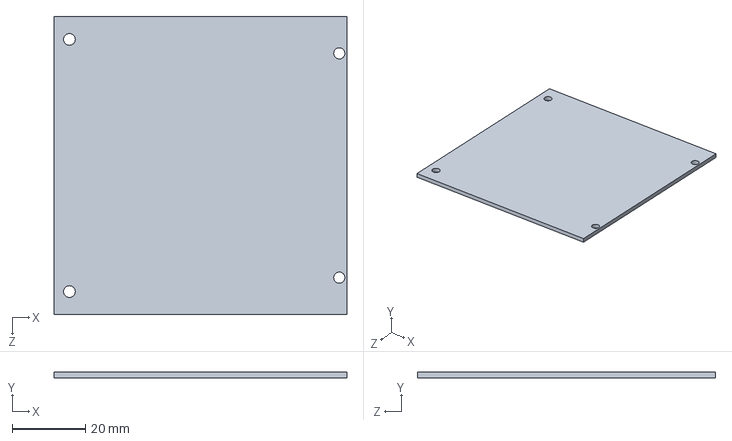
[picture p96: CAD file, 2019-06-20]
Mechanical/Chassis/UnoStackPCB.SLDPRT
79.8 x 1.60 x 81.3 mm
