tpbw4321/Slugnificant-Seven/Mechanical/FiringMechanism/BrassCoupling.SLDPRT

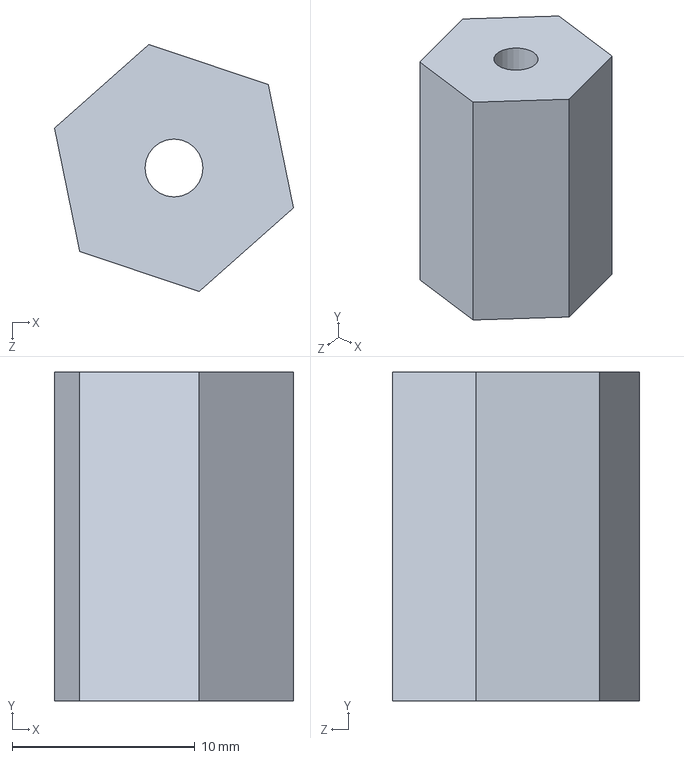
[picture p97: CAD file, 2019-06-20]
Mechanical/FiringMechanism/BrassCoupling.SLDPRT
13.1 x 18.0 x 13.5 mm
