tpbw4321/Slugnificant-Seven/Mechanical/FiringMechanism/PlatformBearingMount.SLDPRT

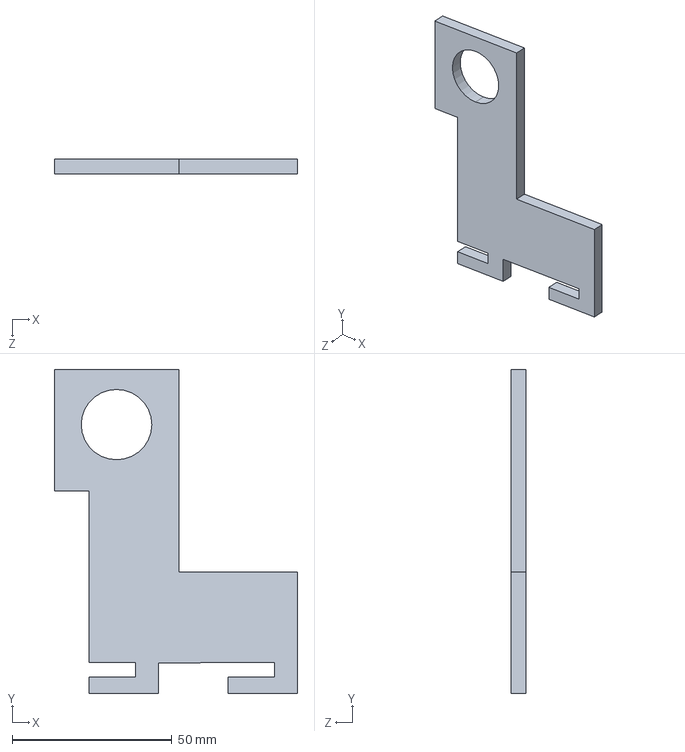
[picture p98: CAD file, 2019-06-20]
Mechanical/FiringMechanism/PlatformBearingMount.SLDPRT
76.2 x 101.5 x 4.80 mm
