tpbw4321/Slugnificant-Seven/Mechanical/Chassis/UnoStackConnector.SLDPRT

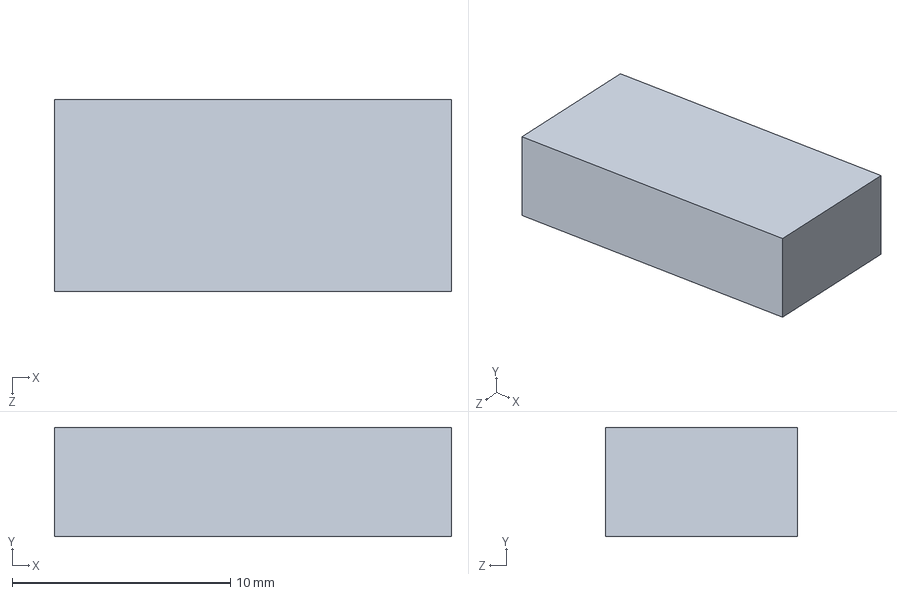
[picture p99: CAD file, 2019-06-20]
Mechanical/Chassis/UnoStackConnector.SLDPRT
18.2 x 5.00 x 8.80 mm
