tpbw4321/Slugnificant-Seven/Mechanical/FiringMechanism/PingPongBall.SLDPRT

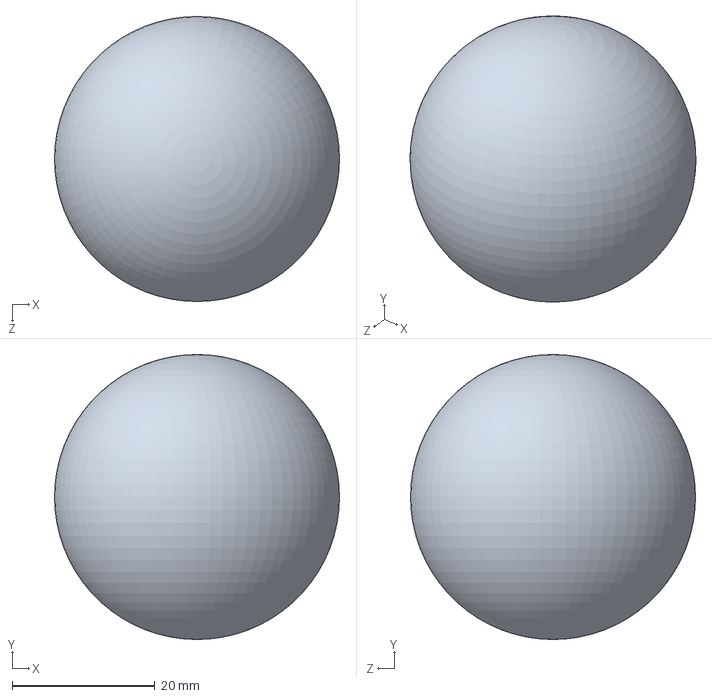
[picture p100: CAD file, 2019-06-20]
Mechanical/FiringMechanism/PingPongBall.SLDPRT
40.0 x 40.0 x 40.0 mm
