tpbw4321/Slugnificant-Seven/Mechanical/Chassis/DRV8814.SLDPRT

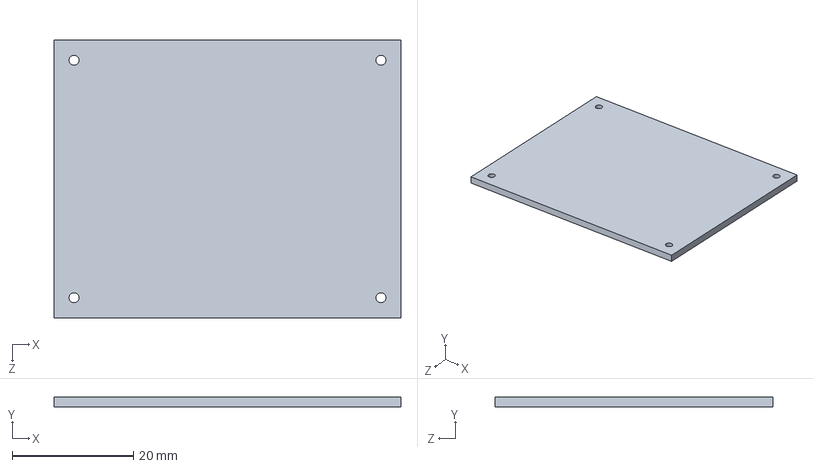
[picture p101: CAD file, 2019-06-20]
Mechanical/Chassis/DRV8814.SLDPRT
57.2 x 1.60 x 45.7 mm
