tpbw4321/Slugnificant-Seven/Mechanical/FiringMechanism/FiringPlatform.SLDPRT

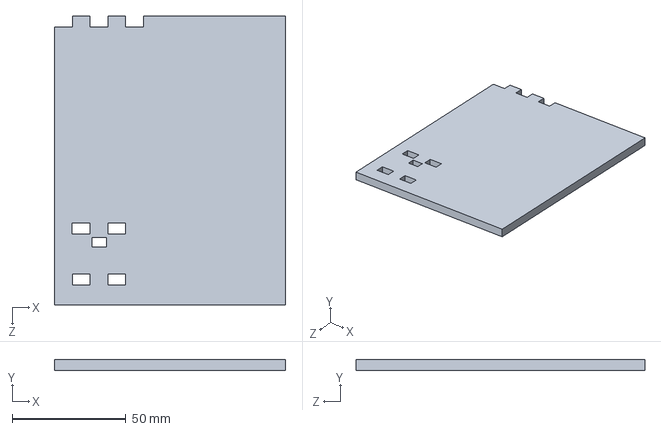
[picture p102: CAD file, 2019-06-20]
Mechanical/FiringMechanism/FiringPlatform.SLDPRT
101.6 x 4.80 x 127.0 mm
