tpbw4321/Slugnificant-Seven/Mechanical/FiringMechanism/BarrelEndCap.SLDPRT

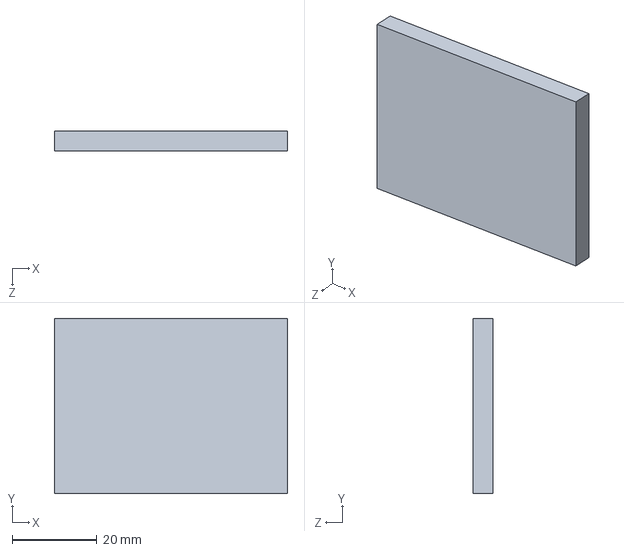
[picture p103: CAD file, 2019-06-20]
Mechanical/FiringMechanism/BarrelEndCap.SLDPRT
54.9 x 41.2 x 4.60 mm
