tpbw4321/Slugnificant-Seven/Mechanical/FiringMechanism/PlatformServoMount.SLDPRT

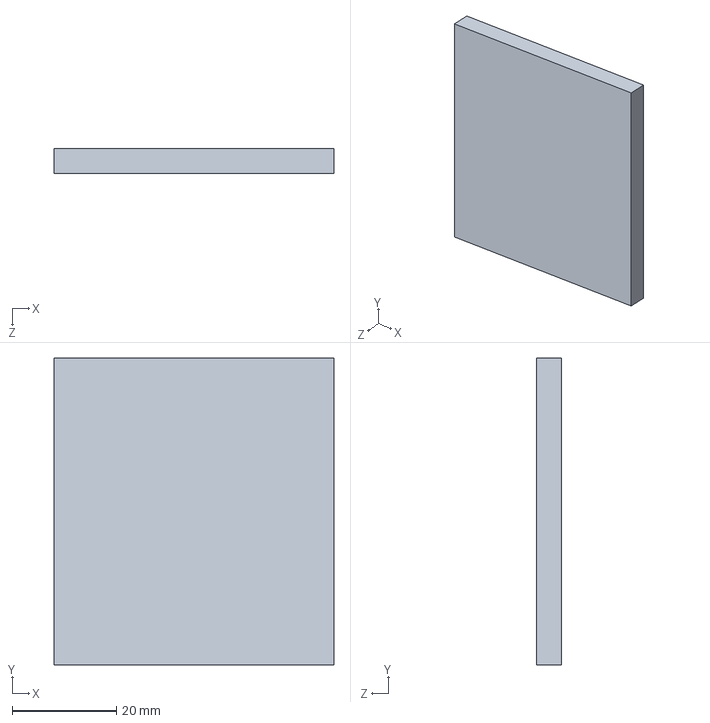
[picture p104: CAD file, 2019-06-20]
Mechanical/FiringMechanism/PlatformServoMount.SLDPRT
53.8 x 59.0 x 4.80 mm
