tpbw4321/Slugnificant-Seven/Mechanical/Chassis/SkidWedge.SLDPRT

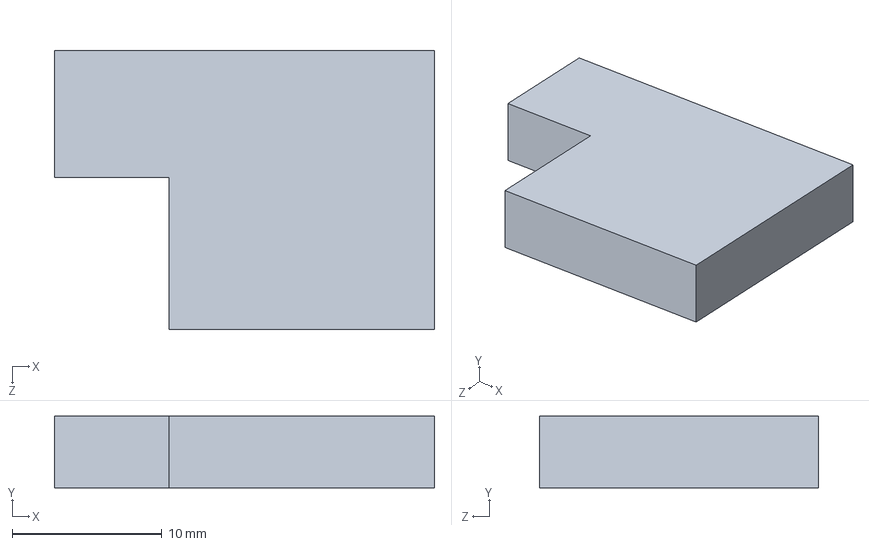
[picture p105: CAD file, 2019-06-20]
Mechanical/Chassis/SkidWedge.SLDPRT
25.4 x 4.80 x 18.6 mm
