tpbw4321/Slugnificant-Seven/Mechanical/FiringMechanism/ServoMount.SLDPRT

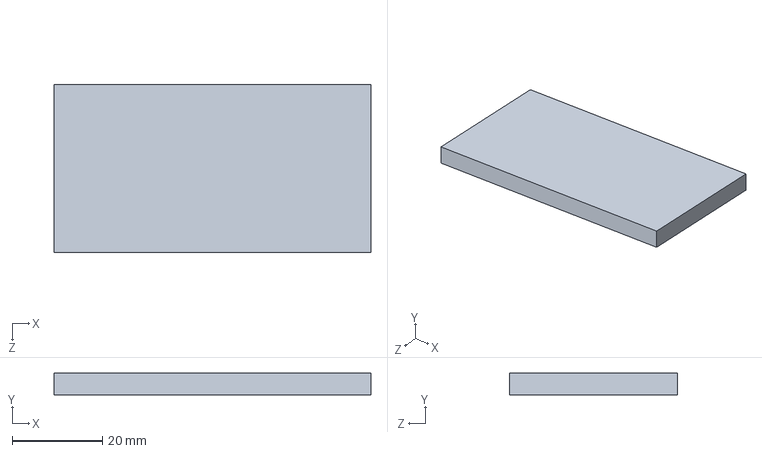
[picture p106: CAD file, 2019-06-20]
Mechanical/FiringMechanism/ServoMount.SLDPRT
70.2 x 4.80 x 37.2 mm
