tpbw4321/Slugnificant-Seven/Mechanical/Chassis/InnerMotorMount.SLDPRT

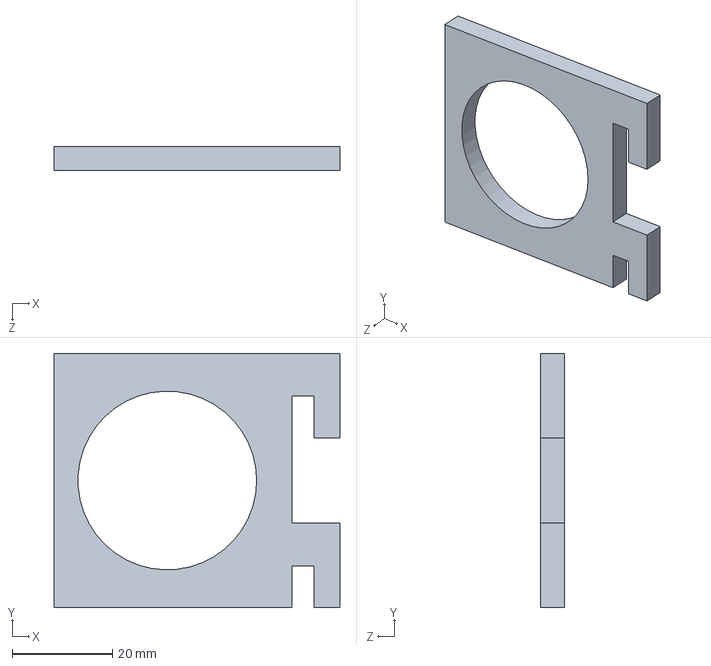
[picture p107: CAD file, 2019-06-20]
Mechanical/Chassis/InnerMotorMount.SLDPRT
57.2 x 50.8 x 4.80 mm
