tpbw4321/Slugnificant-Seven/Mechanical/Chassis/BeaconPlatform.SLDPRT

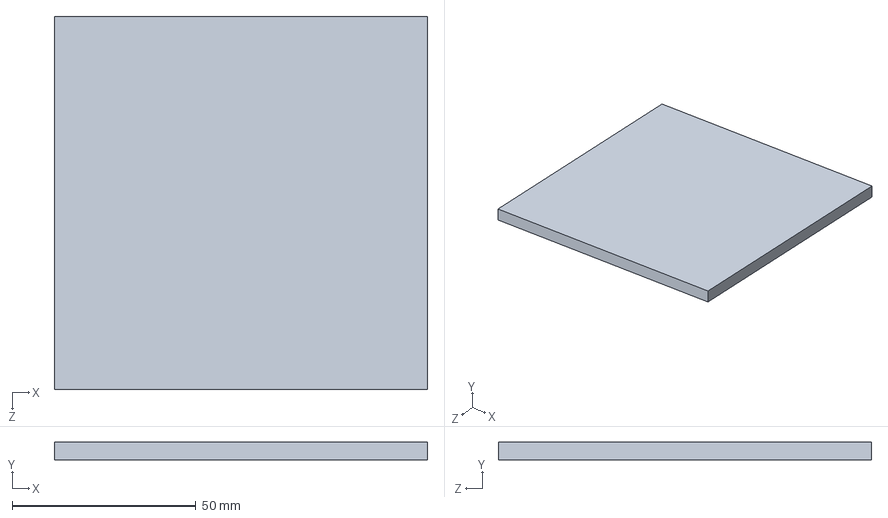
[picture p108: CAD file, 2019-06-20]
Mechanical/Chassis/BeaconPlatform.SLDPRT
101.6 x 4.83 x 101.6 mm
