tpbw4321/Slugnificant-Seven/Mechanical/Chassis/HexRiser.SLDPRT

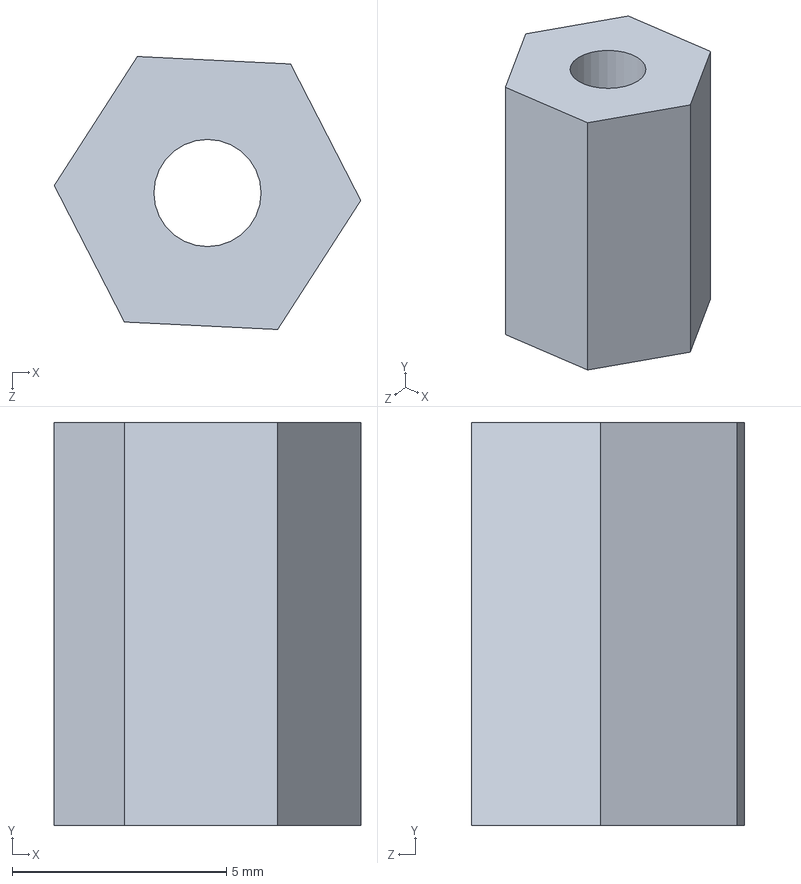
[picture p109: CAD file, 2019-06-20]
Mechanical/Chassis/HexRiser.SLDPRT
7.15 x 9.40 x 6.37 mm
