tpbw4321/Slugnificant-Seven/Mechanical/FiringMechanism/PitcherWheel.SLDPRT

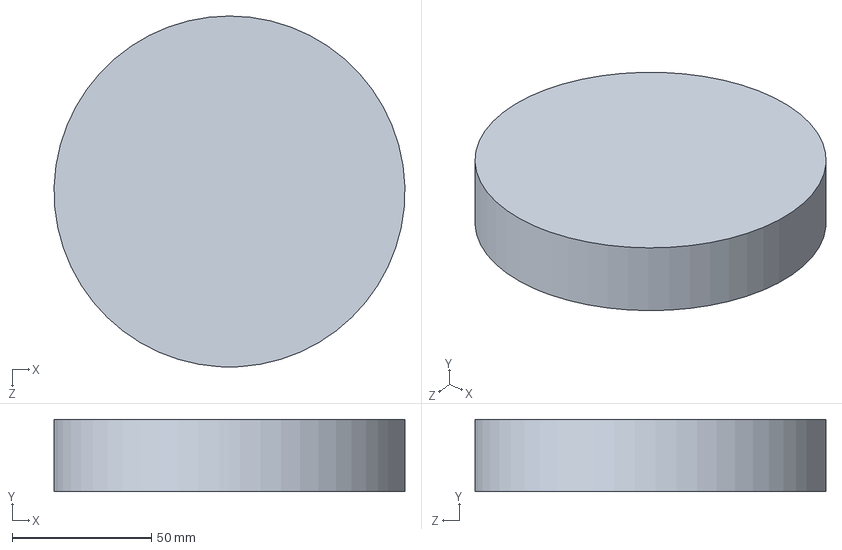
[picture p110: CAD file, 2019-06-20]
Mechanical/FiringMechanism/PitcherWheel.SLDPRT
125.9 x 26.0 x 126.0 mm
