tpbw4321/Slugnificant-Seven/Mechanical/Chassis/MotorMountWedge.SLDPRT

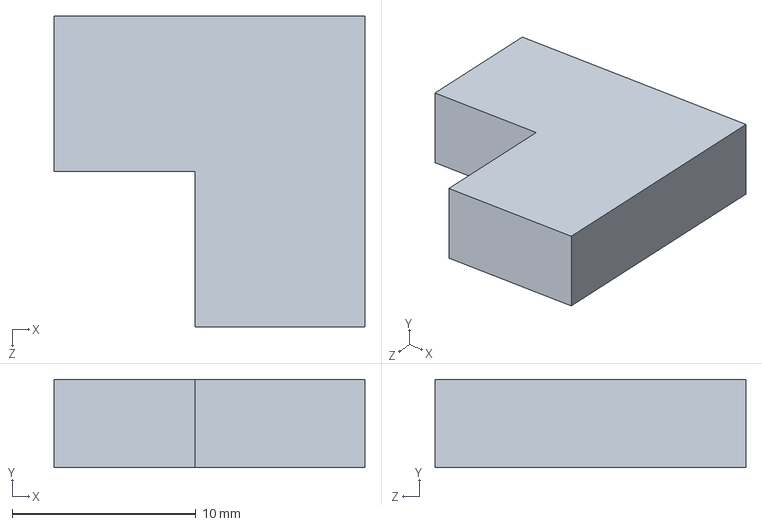
[picture p111: CAD file, 2019-06-20]
Mechanical/Chassis/MotorMountWedge.SLDPRT
16.9 x 4.80 x 16.9 mm
