tpbw4321/Slugnificant-Seven/Mechanical/FiringMechanism/BarrelTop.SLDPRT

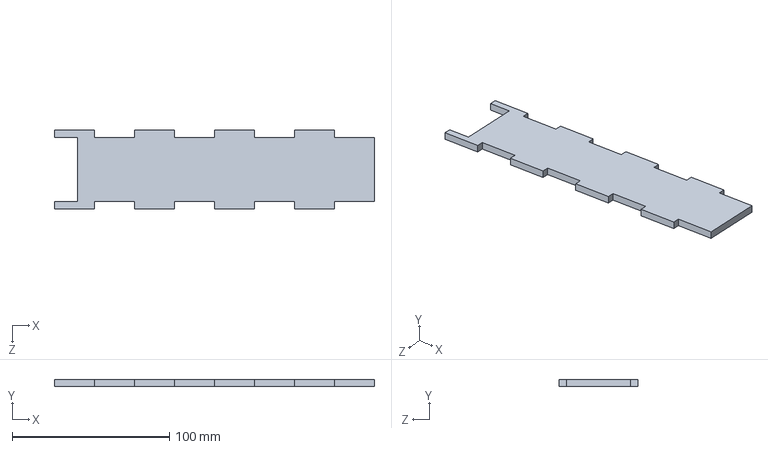
[picture p112: CAD file, 2019-06-20]
Mechanical/FiringMechanism/BarrelTop.SLDPRT
203.2 x 4.60 x 49.9 mm
