tpbw4321/Slugnificant-Seven/Mechanical/Chassis/Top Layer.SLDPRT

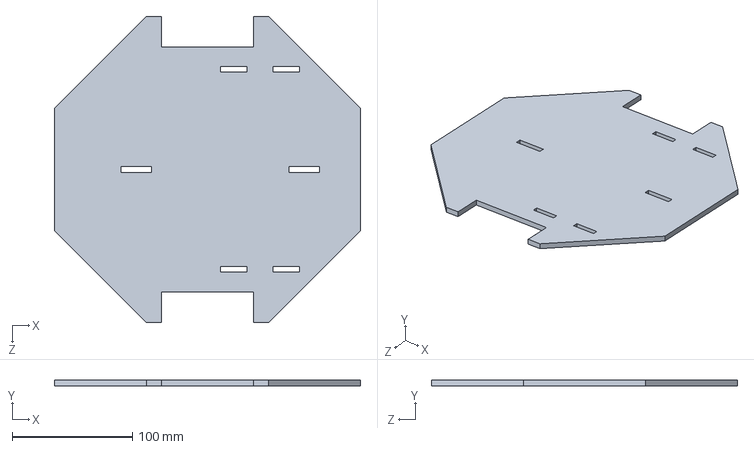
[picture p113: CAD file, 2019-06-20]
Mechanical/Chassis/Top Layer.SLDPRT
254.0 x 4.80 x 254.0 mm
