tpbw4321/Slugnificant-Seven/Mechanical/Chassis/Bumper.SLDPRT

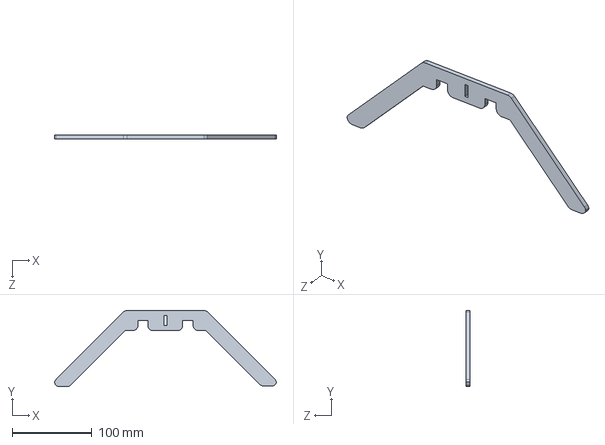
[picture p114: CAD file, 2019-06-20]
Mechanical/Chassis/Bumper.SLDPRT
279.2 x 96.0 x 4.80 mm
