tpbw4321/Slugnificant-Seven/Mechanical/Chassis/HoppeLongWall.SLDPRT

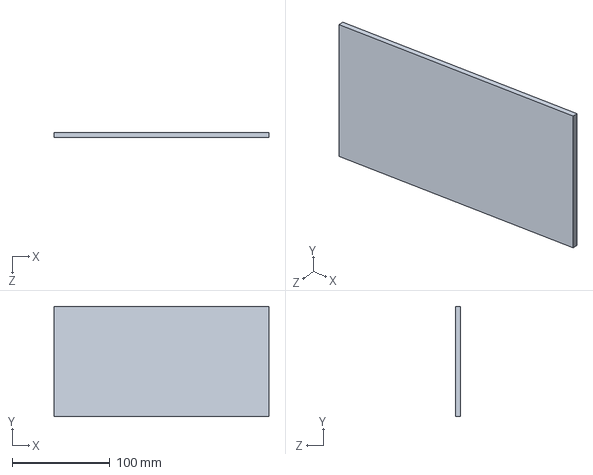
[picture p115: CAD file, 2019-06-20]
Mechanical/Chassis/HoppeLongWall.SLDPRT
219.7 x 112.5 x 4.60 mm
