tpbw4321/Slugnificant-Seven/Mechanical/Chassis/BeaconBottom.SLDPRT

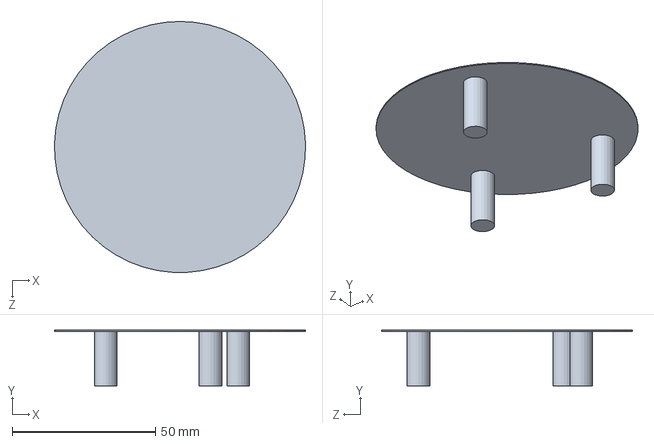
[picture p116: CAD file, 2019-06-20]
Mechanical/Chassis/BeaconBottom.SLDPRT
87.6 x 19.4 x 87.6 mm
