tpbw4321/Slugnificant-Seven/Mechanical/Chassis/HopperShortCorner.SLDPRT

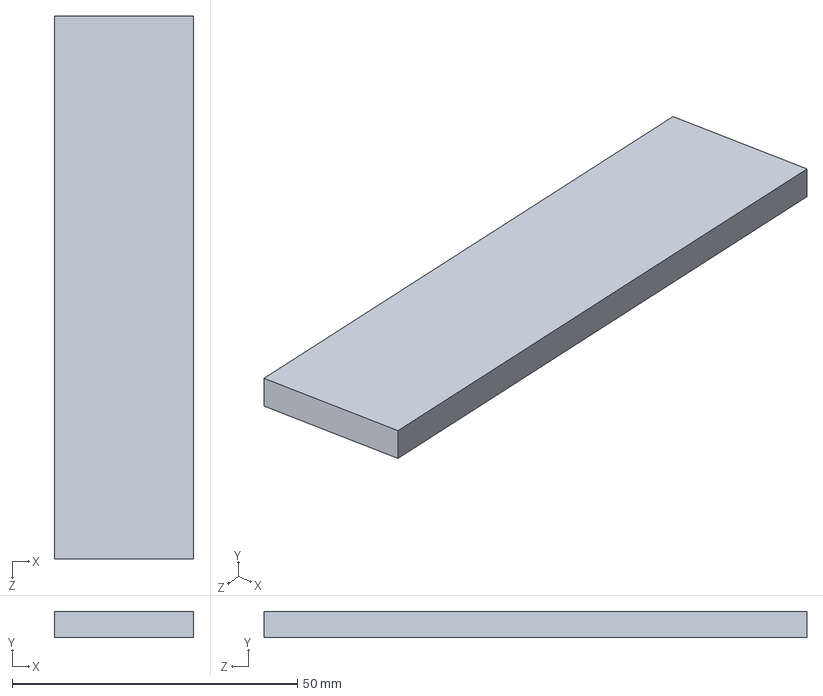
[picture p117: CAD file, 2019-06-20]
Mechanical/Chassis/HopperShortCorner.SLDPRT
24.4 x 4.60 x 95.2 mm
