tpbw4321/Slugnificant-Seven/Mechanical/Chassis/MotorMountOutter.SLDPRT

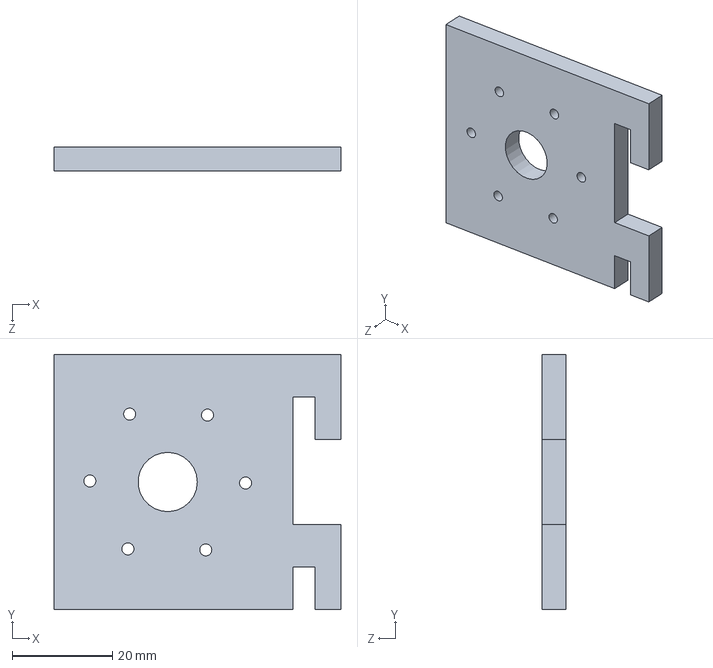
[picture p118: CAD file, 2019-06-20]
Mechanical/Chassis/MotorMountOutter.SLDPRT
57.1 x 50.8 x 4.80 mm
