tpbw4321/Slugnificant-Seven/Mechanical/Chassis/HopperRightWall.SLDPRT

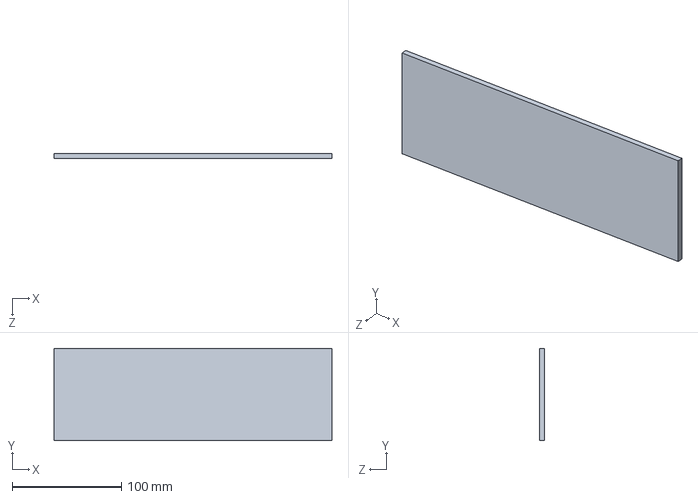
[picture p119: CAD file, 2019-06-20]
Mechanical/Chassis/HopperRightWall.SLDPRT
254.0 x 84.3 x 4.57 mm
