tpbw4321/Slugnificant-Seven/Mechanical/Chassis/BumperV2.SLDPRT

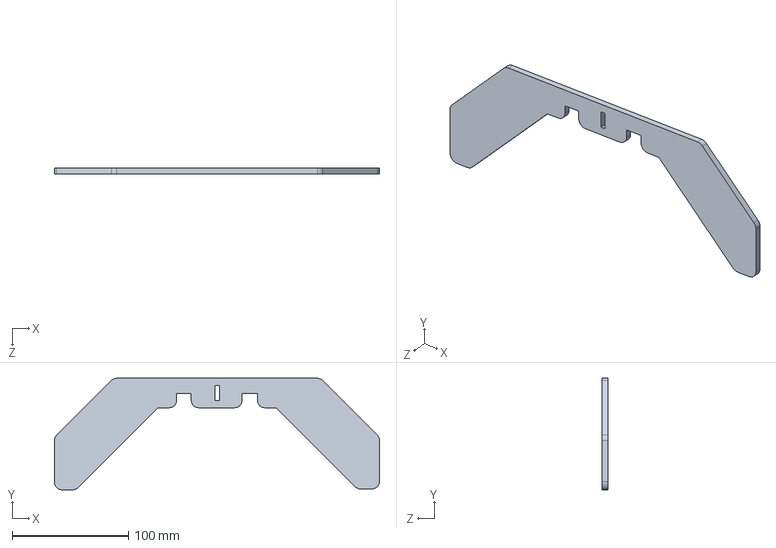
[picture p120: CAD file, 2019-06-20]
Mechanical/Chassis/BumperV2.SLDPRT
279.4 x 96.0 x 4.80 mm
