tpbw4321/Slugnificant-Seven/Mechanical/Chassis/HopperNormalSide.SLDPRT

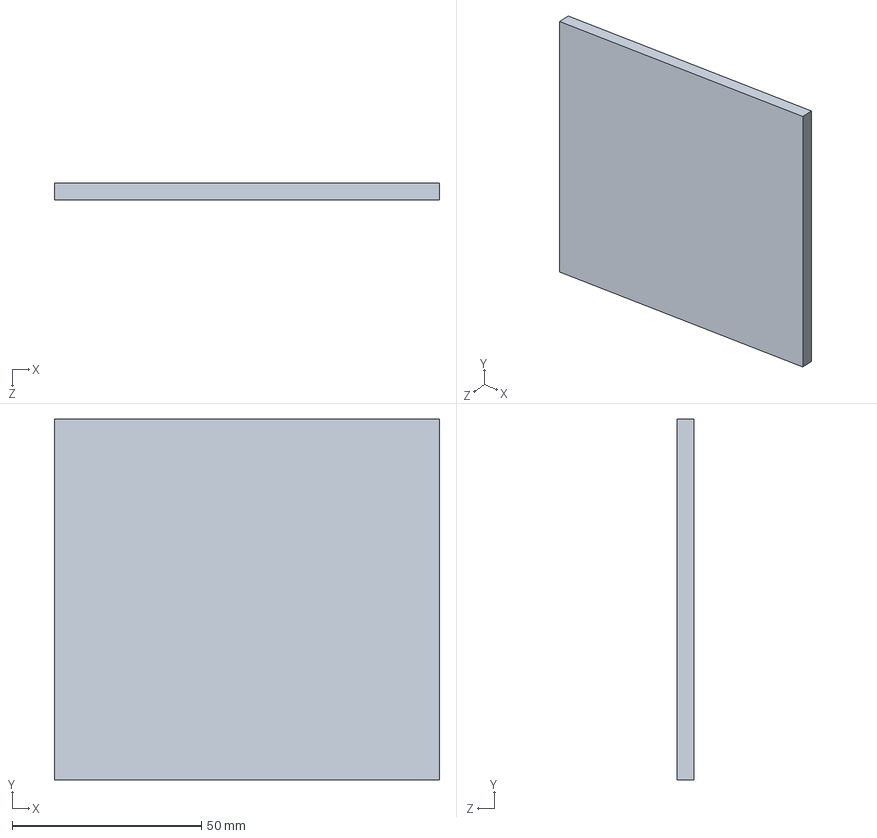
[picture p121: CAD file, 2019-06-20]
Mechanical/Chassis/HopperNormalSide.SLDPRT
101.6 x 95.2 x 4.60 mm
