tpbw4321/Slugnificant-Seven/Mechanical/Chassis/PlatformMountWedge.SLDPRT

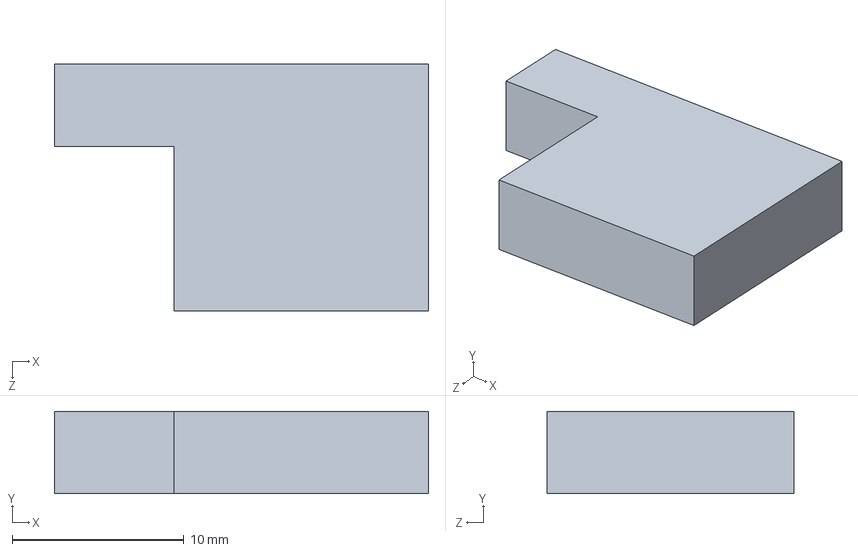
[picture p122: CAD file, 2019-06-20]
Mechanical/Chassis/PlatformMountWedge.SLDPRT
21.8 x 4.80 x 14.4 mm
