tpbw4321/Slugnificant-Seven/Mechanical/Chassis/HopperTop.SLDPRT

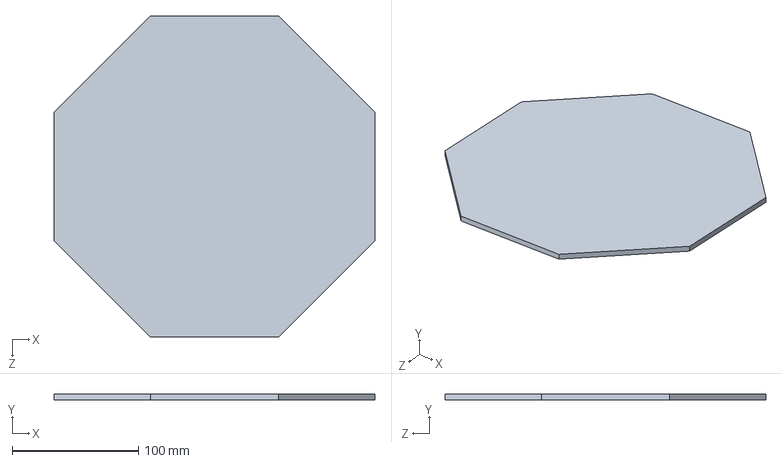
[picture p123: CAD file, 2019-06-20]
Mechanical/Chassis/HopperTop.SLDPRT
254.0 x 4.60 x 254.0 mm
