tpbw4321/Slugnificant-Seven/Mechanical/Chassis/Motor.SLDPRT

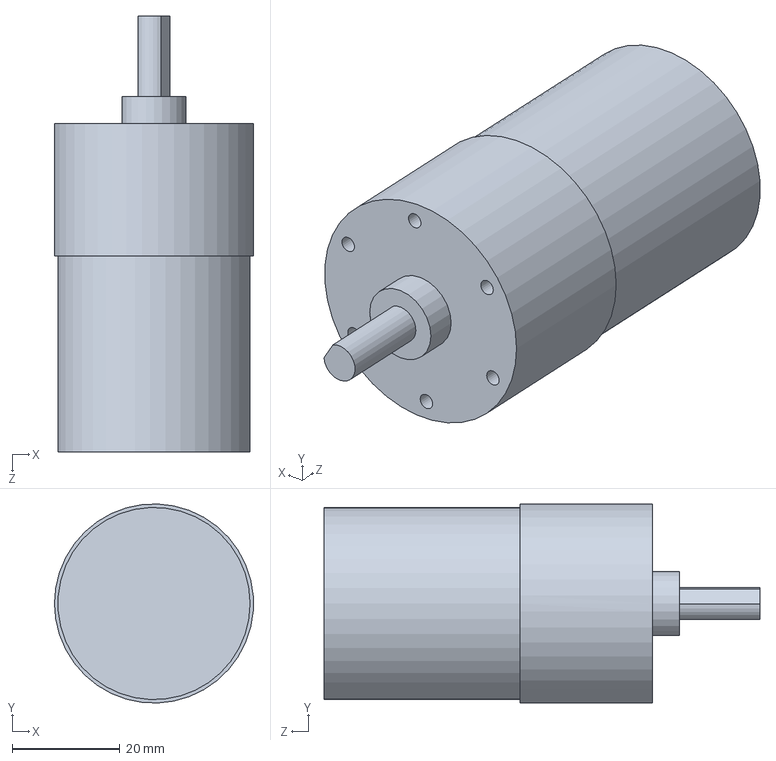
[picture p124: CAD file, 2019-06-20]
Mechanical/Chassis/Motor.SLDPRT
37.0 x 37.0 x 81.0 mm
