tpbw4321/Slugnificant-Seven/Mechanical/Chassis/TallHexRiser.SLDPRT

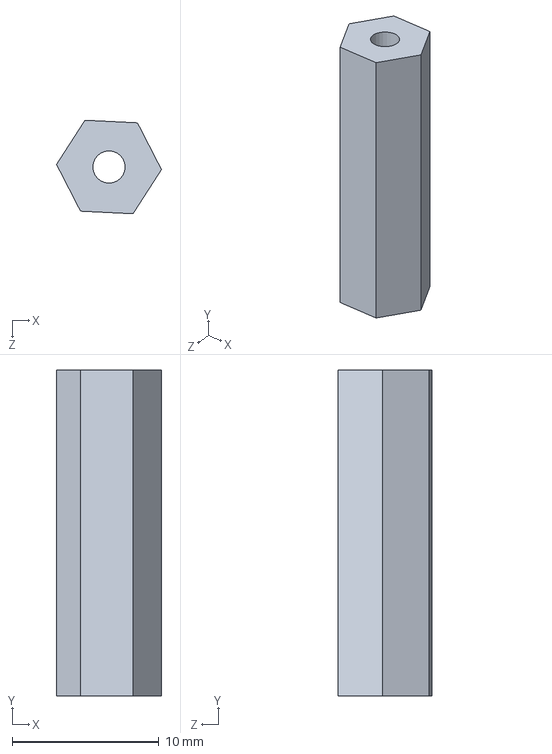
[picture p125: CAD file, 2019-06-20]
Mechanical/Chassis/TallHexRiser.SLDPRT
7.15 x 22.2 x 6.37 mm
