tpbw4321/Slugnificant-Seven/Mechanical/Chassis/HopperLongCornerWall.SLDPRT

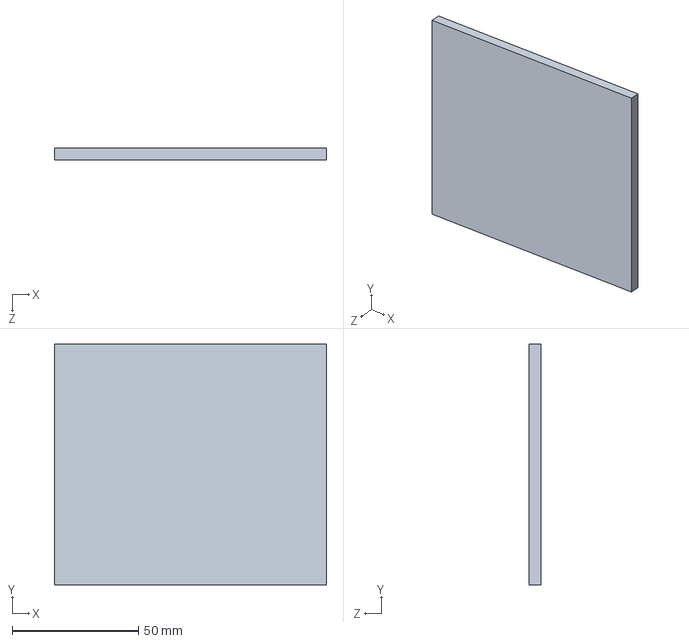
[picture p126: CAD file, 2019-06-20]
Mechanical/Chassis/HopperLongCornerWall.SLDPRT
107.7 x 95.2 x 4.60 mm
