tpbw4321/Slugnificant-Seven/Mechanical/Chassis/DS3658 PCB.SLDPRT

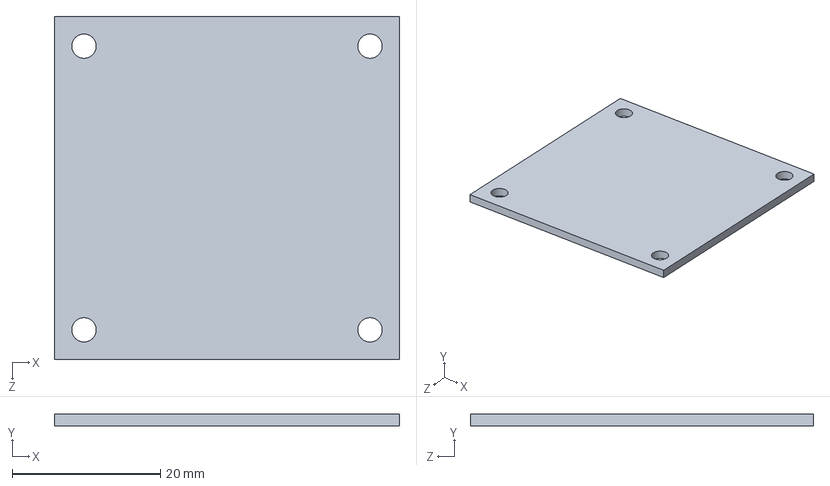
[picture p127: CAD file, 2019-06-20]
Mechanical/Chassis/DS3658 PCB.SLDPRT
46.6 x 1.60 x 46.3 mm
