tpbw4321/Slugnificant-Seven/(list of files, cad)

Other CAD files:
Mechanical/Chassis/TCRT5000/TCRT5000.stp
Mechanical/Chassis/GE.sldprt
Mechanical/Chassis/LEDs.sldprt
Mechanical/Chassis/HopperBottomFrontRight.SLDPRT
Mechanical/Chassis/TCRT5000 v1.sldprt
Mechanical/FiringMechanism/BarrelRight.SLDPRT
Mechanical/Chassis/HopperBottomFront.SLDPRT
Mechanical/FiringMechanism/BarrelLeftRight.SLDPRT
Mechanical/FiringMechanism/SG-JIANRONG-MG996_1.sldprt
Mechanical/Chassis/HopperBottomBackRight.SLDPRT
Mechanical/Chassis/Metal Contacts.sldprt
Mechanical/FiringMechanism/XIANTAO.sldprt
Mechanical/Chassis/HopperBottomBottomRight.SLDPRT
Mechanical/FiringMechanism/ServoPlatformMount .SLDPRT
Mechanical/FiringMechanism/ZK_1.sldprt
Mechanical/Chassis/HopperBottomBackLeft.SLDPRT
Mechanical/Chassis/Skid.SLDPRT
Mechanical/Chassis/Bottom Layer.SLDPRT
Mechanical/Chassis/DG-SZ.sldprt
Mechanical/Chassis/HopperBottomRight.SLDPRT
Mechanical/Chassis/HopperBottomTemplate.SLDPRT
Mechanical/Chassis/HopperBottomBack.SLDPRT
Mechanical/Chassis/HopperBottomFrontLeft.SLDPRT
Mechanical/Chassis/BumperV2.SLDDRW
Mechanical/Chassis/CutMe.SLDDRW
Mechanical/Chassis/MotorizedPlatformDrawing.SLDDRW
Mechanical/Chassis/TCRT5000/TCRT5000.f3d
Mechanical/Chassis/TCRT5000/TCRT5000.igs
Mechanical/Chassis/WedgesPrint.SLDDRW
Mechanical/Chassis/Wheel.SLDPRT
Mechanical/LoadingMechanism/S90Servo/SG90 - Micro Servo 9g - Tower Pro.x_t
